andreika-git/deucalion/Connectors/pcb-connector-overview-2.png

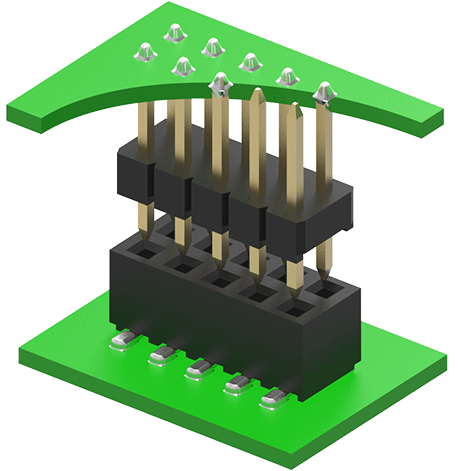
Connectors/pcb-connector-overview-2.png
