andreika-git/deucalion/sketches/3d_test1.jpg

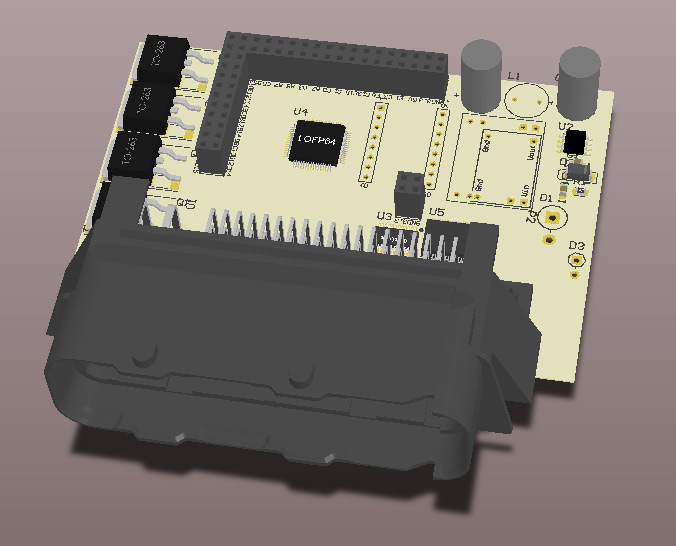
sketches/3d_test1.jpg
