andreika-git/deucalion/Core407v/README.md

# Core407V STM32F407VET6 Black board

Dimensions: 85.1mm x 72.45mm

More info at https://github.com/mcauser/BLACK_F407VE

Also, there's another board, with slightly different layout:
https://github.com/mcauser/BLACK_F407ZE
