andreika-git/deucalion/Core407z/README.md

# Core407z STM32F407ZET6 Black board

Dimensions: 95.1mm x 74.6mm

More info at https://github.com/mcauser/BLACK_F407ZE

Also, there's another board, with slightly different layout:
https://github.com/mcauser/BLACK_F407VE
