andreika-git/deucalion/Modules/STM32H743VIT6-mini/README.md

1st option:
	https://www.aliexpress.com/item/4000235276780.html
	= $19.73

2nd option:
	https://www.aliexpress.com/item/4000067780112.html
	= $30

3rd option:
	https://www.aliexpress.com/item/4000295397211.html
	= $23.80

4th option:
	https://www.aliexpress.com/item/4000063078887.html
	= $28.20
	* Size: 51mm x 47mm
	* no SD-card

5th option:
	NUCLEO-H743ZI or NUCLEO-H743ZI2
	https://www.digikey.com/product-detail/en/stmicroelectronics/NUCLEO-H743ZI2/497-19452-ND/10130892
	= $27.00
	https://www.aliexpress.com/item/32855593053.html
	= $34.10
