andreika-git/deucalion/Modules/STM32F407VET6-mini/README.md

# "STM32F407VET6 mini" "VCC-GND" Blue board

www.vcc-gnd.com
http://www.vcc-gnd.com/cp/stm32hxb/stm32f4xxhexinban/

Dimensions: 49.53mm x 39.37mm

More info at https://github.com/mcauser/VCC_GND_F407

https://wiki.stm32duino.com/index.php?title=Vcc-gnd.com_STM32F407VET6_Mini

https://www.ebay.com/itm/Mini-core-board-STM32-minimum-system-version-STM32F407VET6/182309828654
= $11.38
https://www.ebay.com/itm/Mini-core-board-STM32-minimum-system-version-STM32F407VET6/182169418538
= $11.89
https://www.ebay.com/itm/STM32F407VET6-ARM-Mini-Version-Core-Board-Cortex-M4-STM32-Minimum-System-Board/162558272520
= $15.35+delivery
https://www.ebay.com/itm/STM32F407VET6-Mini-version-of-the-core-board-STM32-minimum-system-version/182169418472
= $13
https://www.ebay.com/itm/STM32F407VET6-STM32-ARM-Cortex-M4-Development-Board-Core-Board-System-Board/123246623468
= $12
https://www.ebay.com/itm/STM32F407VET6-Mini-version-of-the-core-board-STM32-minimum-system-version/291791335845
= $13
https://www.ebay.com/itm/STM32F407VET6-Mini-version-of-the-Ader-Tafel-STM32-minimum-system-version/172387871994
= $14

https://www.aliexpress.com/item/Embedded-Development-Board-STM32F407VET6-Mini-Core-Board-Minimum-System-Version-STM32F4/32972483336.html
= $19
https://www.aliexpress.com/item/Source-STM32F407VET6-Version-Mini-Version-of-the-STM32-ARMCortex-M4-Core-Board-System/32819146937.html
= $24

There's a cheaper option WITHOUT SD-card slot (slightly bigger? :( ):
https://www.ebay.com/itm/STM32F407VGT6-ARM-Cortex-M4-32bit-MCU-Core-Development-Board-STM32F4Discovery/112159189243
= $9.38 (Black board)
https://www.ebay.com/itm/Open407V-D-Core407V-Development-Board-Standard-STM32F4-DISCOVERY-ARM-Cortex-M4/172740399220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
= $9.36 (Pink board, "STM32F407VGT6" option)

---------------------------------------

Upgrade options:
- replace CPU chip STM32F407VET6 with much more powerful STM32H743VI
- replace EEPROM chip AT24C08 with more capacious AT24CM02
- replace RT9193 regulator with more stable & high-current MIC5319-3.3YD5 (or with external 5V->3.3V regulator in SOT223 package)
