andreika-git/deucalion/Modules/LIN/README.md

*** LIN/K-line ISO9141 Transceiver Module ***

Header connector pinout:
1 = +V12
2 = +3.3V
3 = GND
4 = RX
5 = TX
6 = LIN

IC used: TJA1029

Module board dims: 16x12 mm 
(2 layer board)
