andreika-git/deucalion/Connectors/Siemens_SIMK41/README.md

Siemens 5WY SIMK41/43 (2 connectors) pinout (partial, not confirmed):
	http://carmasters.org/topic/2373-%D1%8D%D0%B1%D1%83-siemens/?page=2
2: ground
3: +12 permanent (K30)
6: CAN-L
7: CAN-H
22: +12 ignition (K15)
47: K-Line (programming)
77: K-Line (diagnostics)
