andreika-git/deucalion/Core407_pinout_compare.xlsx

Sheet: Лист1
 | Port A |  |  |  |  | Port B |  |  |  |  | Port C |  |  |  |  | Port D |  |  |  |  | Port E |  |  |  | Port F |  |  |  | Port G
PIN | function | board | VE | ZE | Min | function | board | VE | ZE | Min | function | board | VE | ZE | Min | function | board | VE | ZE | Min | function | VE | ZE | Min | function | VE | ZE | Min | function | VE | ZE | Min
0 | UTX4 | BTN | 23 | 23 | 21 |  | FLASH | 33 | 33 | 31 |  |  | 17 | 19 | 17 | CRX1 |  | 126 | 122 | 216 |  | 112 | 2 | 7 |  |  | 10 |  |  |  | 41
1 | URX4 |  | 24 | 26 | 23 |  |  | 34 | 36 | 32 |  |  | 18 | 22 | 18 | CTX1 |  | 125 | 121 | 127 |  | 111 | 1 | 8 |  |  | 9 |  |  |  | 44
2 | UTX2 |  | 25 | 25 | 22 | BOOT1 | BOOT1 |  | 35 | 33 | MISO2 |  | 19 | 21 | 19 | URX5 | MMC | 124 | 120 | 218 |  | 11 | 4 | 9 |  |  | 12 |  |  |  | 144
3 | URX2 |  | 26 | 28 | 24 | SCK13* | FLASH | 118 | 107 | 224 | MOSI2 |  | 20 | 24 | 20 |  |  | 123 | 119 | 219 |  | 12 | 3 | 10 |  |  | 11 |  |  |  | 143
4 |  |  | 27 | 27 | 25 | MISO13 | FLASH |  | 106 | 225 |  |  | 31 | 31 | 29 |  |  | 122 | 118 | 220 |  | 13 | 6 | 11 |  |  | 14 |  |  |  | 142
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
