andreika-git/deucalion/Connectors/55_BS032.jpg

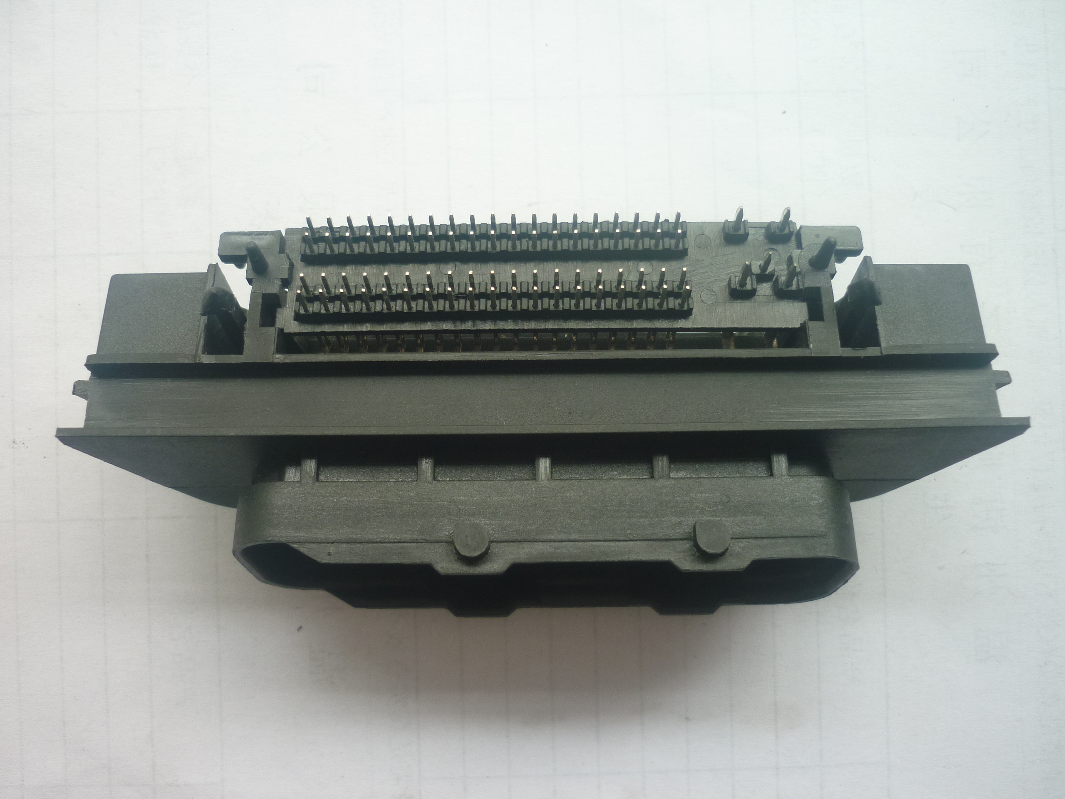
Connectors/55_BS032.jpg
