andreika-git/deucalion/Connectors/55_BS032_2.jpg

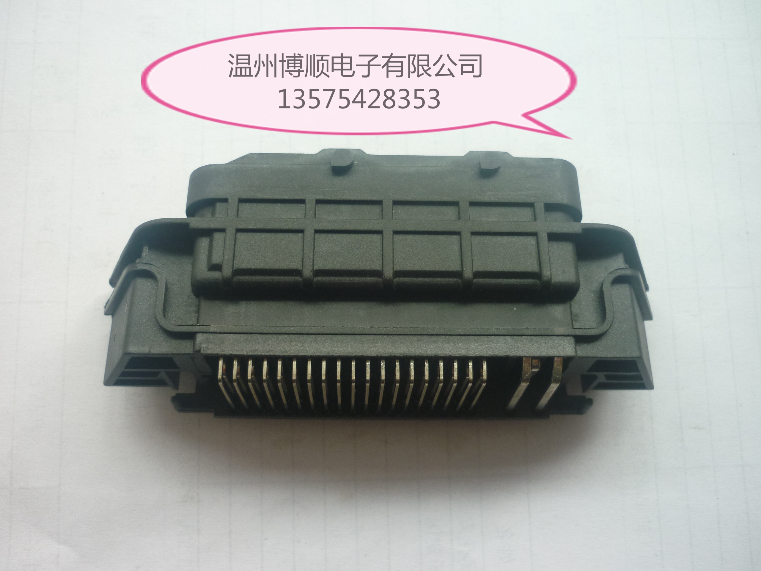
Connectors/55_BS032_2.jpg
