andreika-git/deucalion/Connectors/DJ7811-1-3.5-10-photo02.jpg

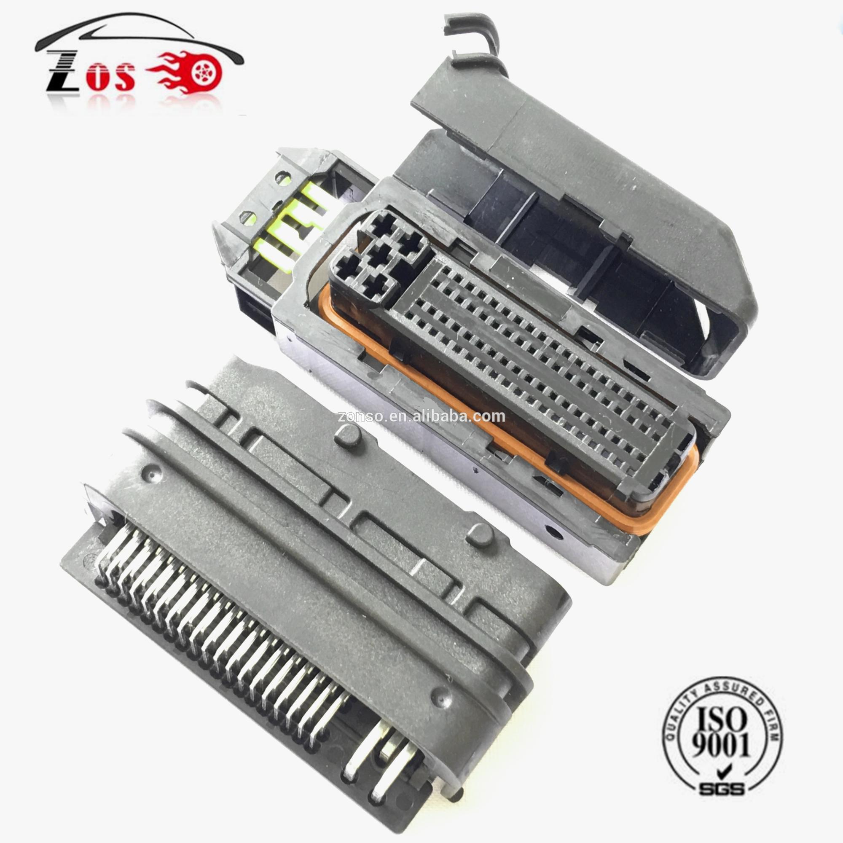
Connectors/DJ7811-1-3.5-10-photo02.jpg
