andreika-git/deucalion/Connectors/DJ7811-1.2-3.5-11.jpg

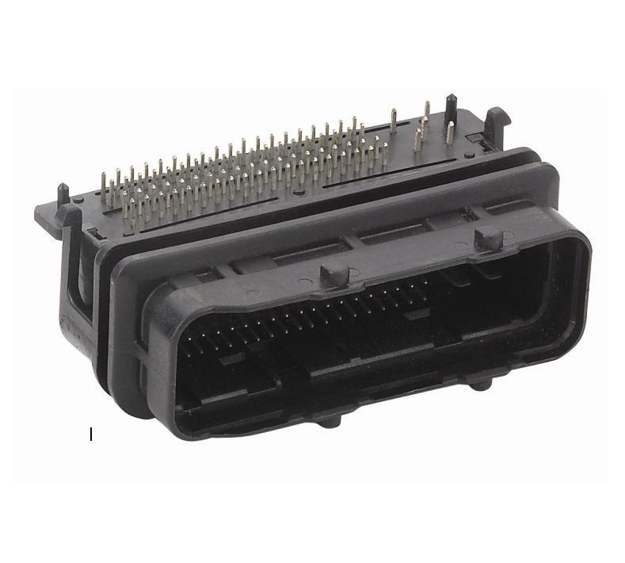
Connectors/DJ7811-1.2-3.5-11.jpg
