andreika-git/deucalion/Connectors/M7.9.7/7.9.7-1.jpg

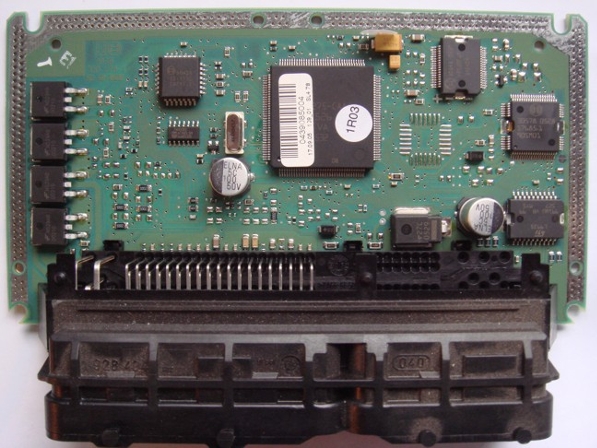
Connectors/M7.9.7/7.9.7-1.jpg
