andreika-git/deucalion/Connectors/M7.9.7/7.9.7-124-1.jpg

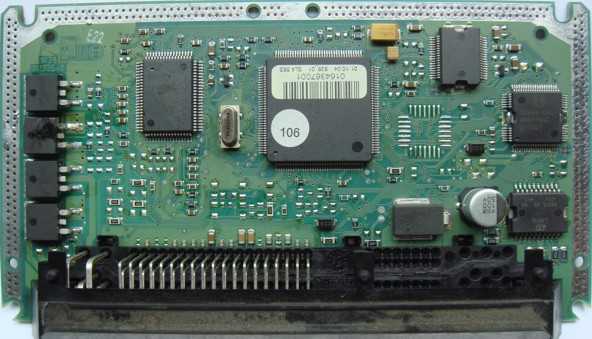
Connectors/M7.9.7/7.9.7-124-1.jpg
