andreika-git/deucalion/Connectors/M7.9.7/121pin_housing_with_connector_inside.jpg

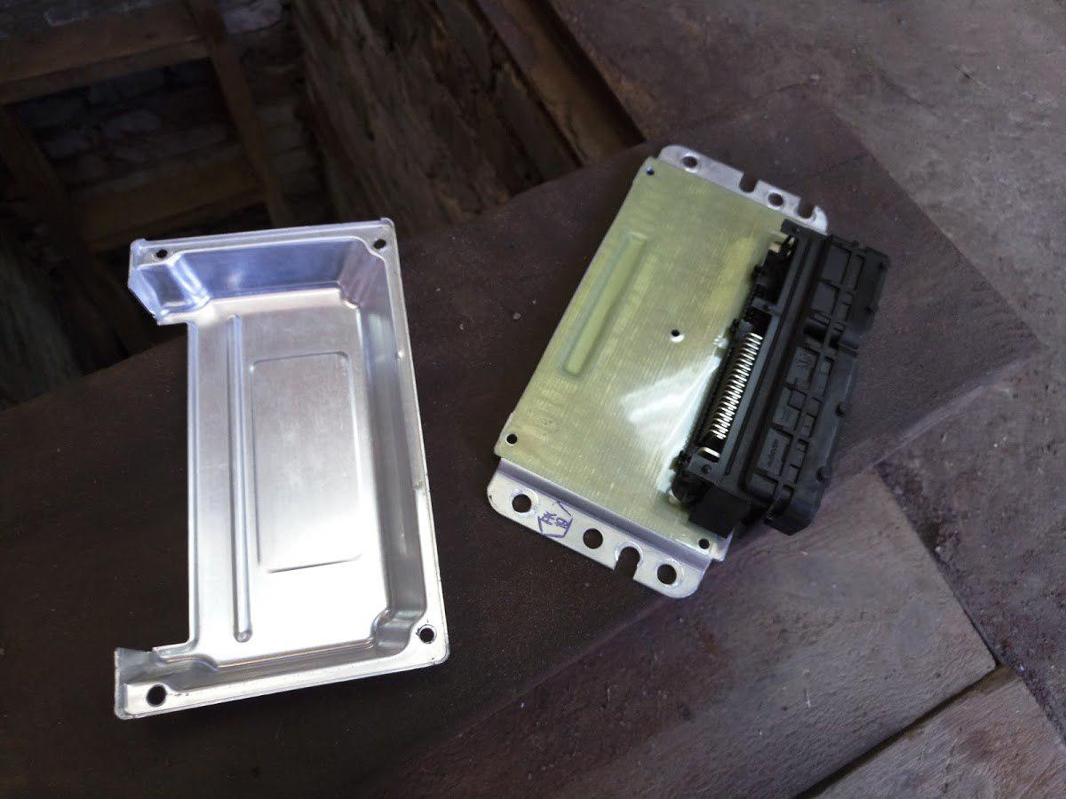
Connectors/M7.9.7/121pin_housing_with_connector_inside.jpg
