andreika-git/deucalion/Connectors/M7.9.7/1118-22-1.jpg

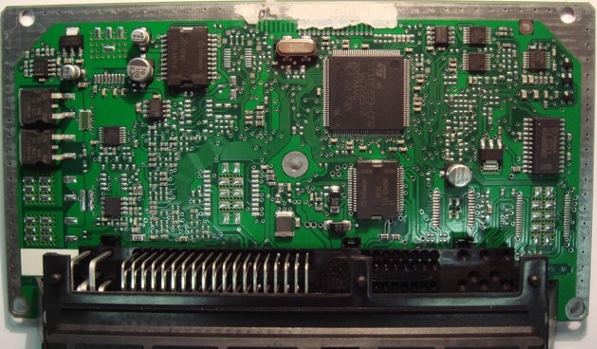
Connectors/M7.9.7/1118-22-1.jpg
