andreika-git/deucalion/Connectors/M7.9.7/2111-82-1.jpg

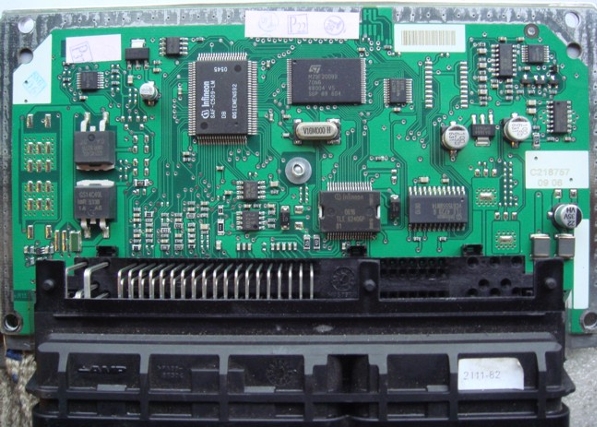
Connectors/M7.9.7/2111-82-1.jpg
