andreika-git/deucalion/Connectors/M7.9.7/11183-22-1.jpg

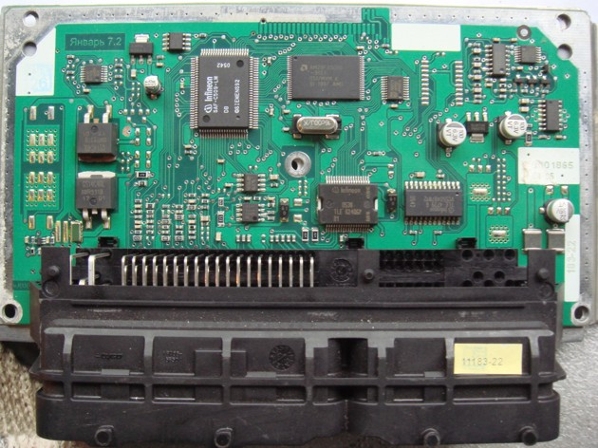
Connectors/M7.9.7/11183-22-1.jpg
