andreika-git/deucalion/Connectors/M7.9.7/21067-12-1.jpg

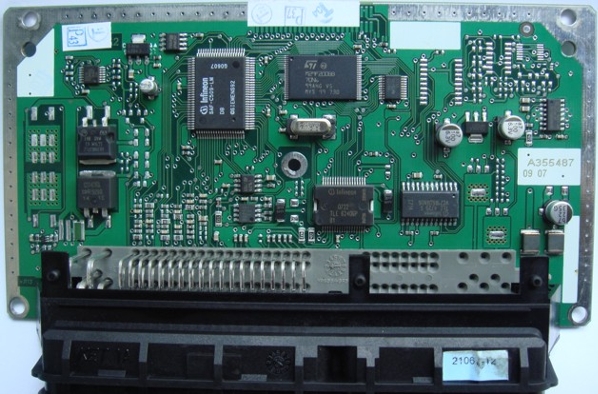
Connectors/M7.9.7/21067-12-1.jpg
