andreika-git/deucalion/Connectors/M7.9.7/21126-1-1.jpg

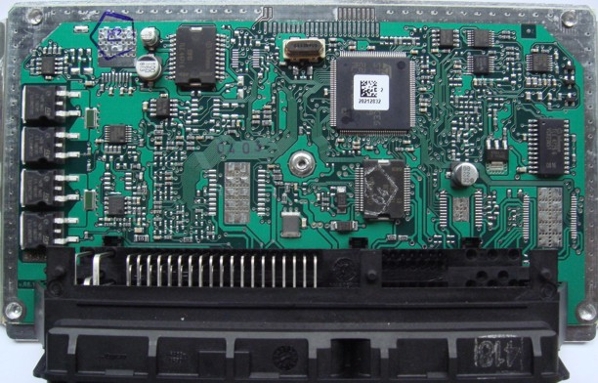
Connectors/M7.9.7/21126-1-1.jpg
