andreika-git/deucalion/Connectors/M7.9.7/board02.jpg

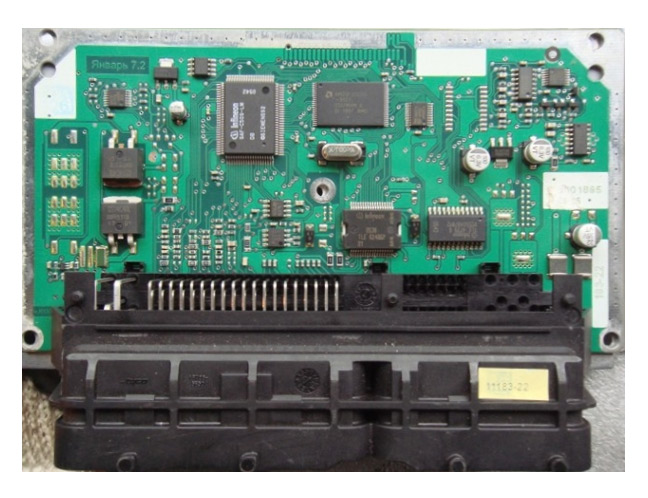
Connectors/M7.9.7/board02.jpg
