andreika-git/deucalion/Connectors/M7.9.7/Bosch_M7.9.7_pinout (janvar72_2111-1411020-8x).gif

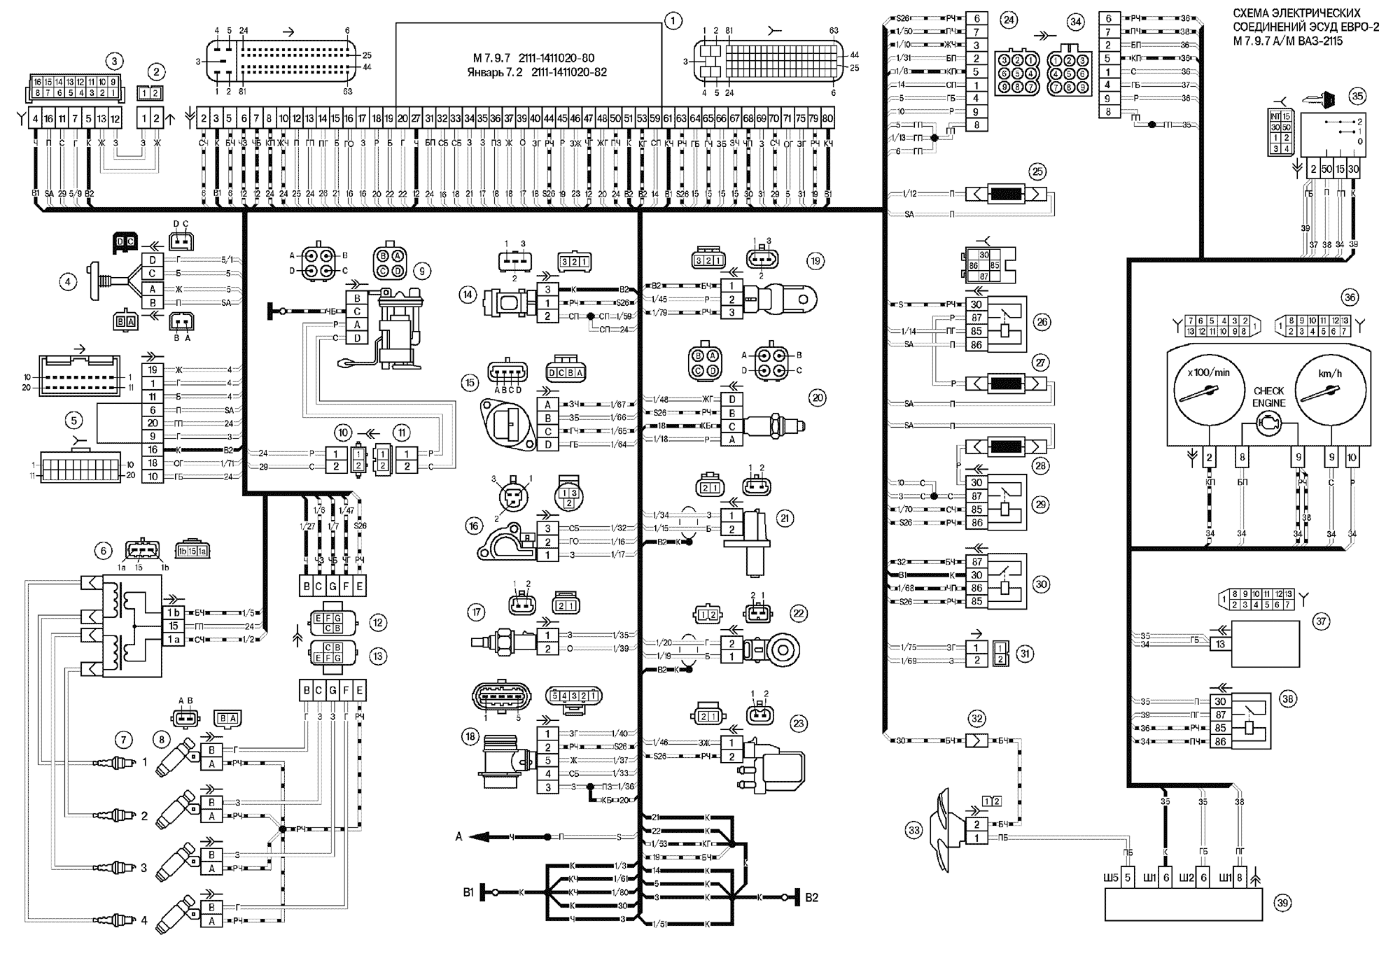
Connectors/M7.9.7/Bosch_M7.9.7_pinout (janvar72_2111-1411020-8x).gif
