andreika-git/deucalion/Connectors/M7.9.7/Bosch_M7.9.7_pinout_rus.jpg

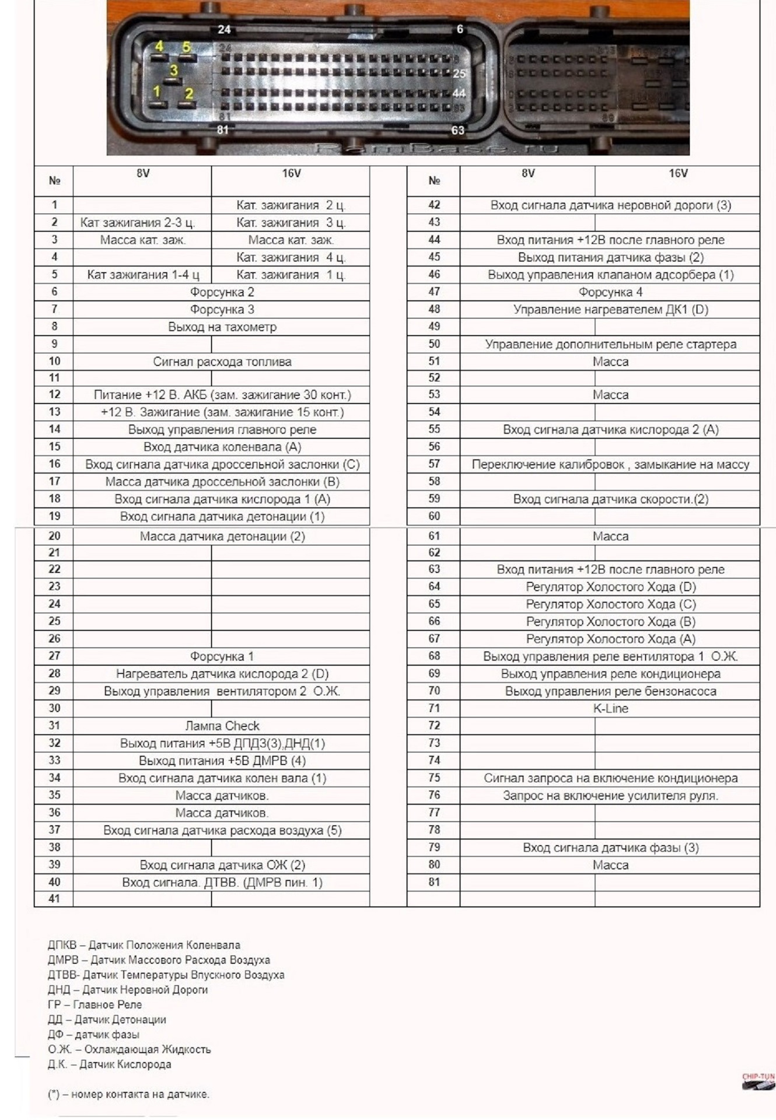
Connectors/M7.9.7/Bosch_M7.9.7_pinout_rus.jpg
