andreika-git/deucalion/Connectors/M7.9.7/chinese_121p.jpg

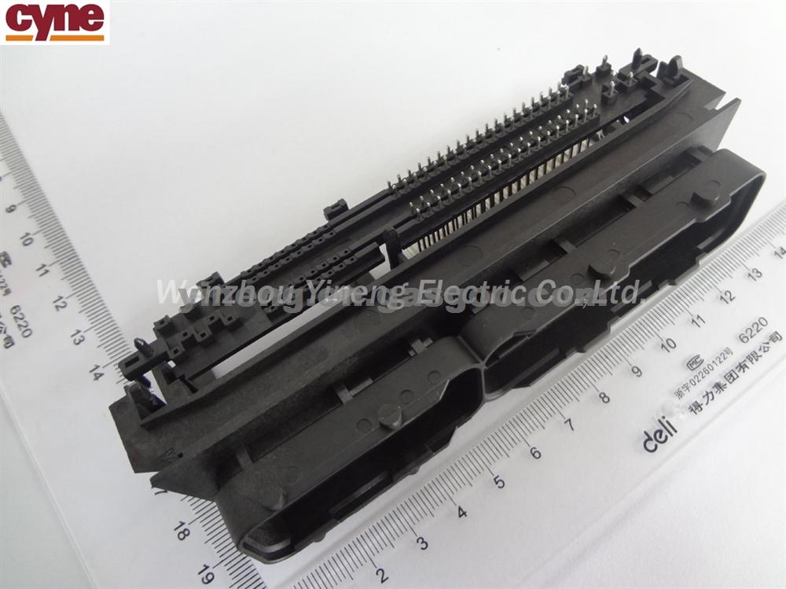
Connectors/M7.9.7/chinese_121p.jpg
