andreika-git/deucalion/Connectors/M7.9.7/janvar72_21124-1411020.jpg

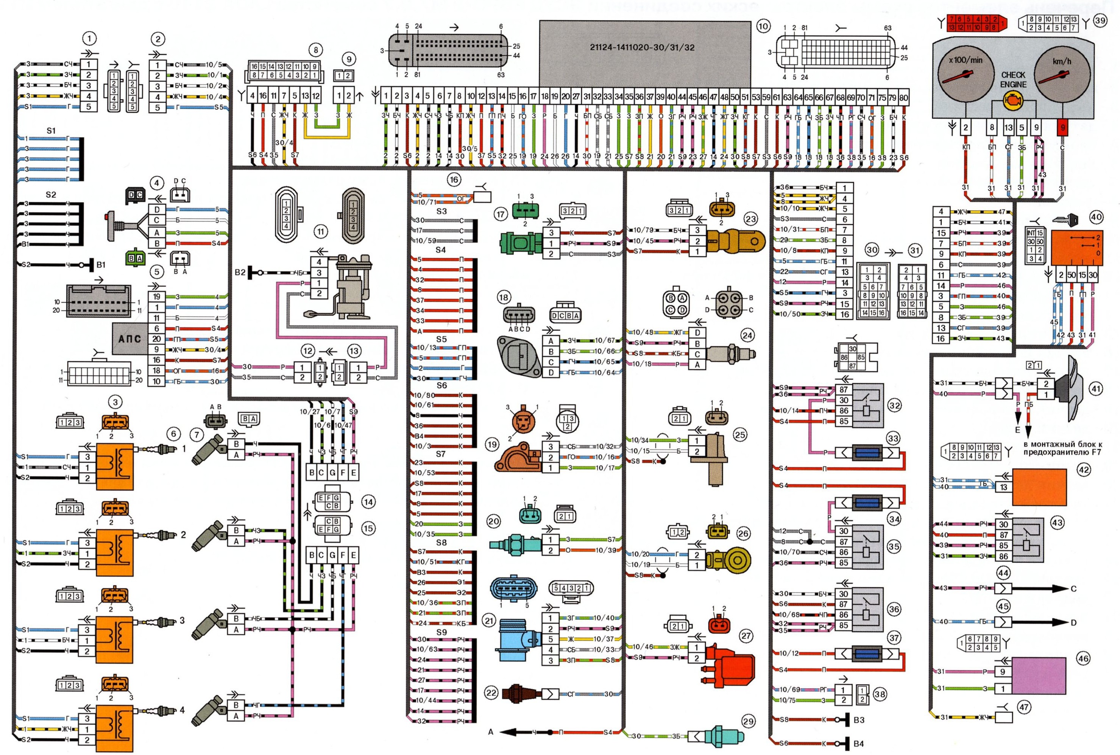
Connectors/M7.9.7/janvar72_21124-1411020.jpg
