andreika-git/deucalion/Connectors/M7.9.7/power-ignition-transistors-footprint-reference.jpg

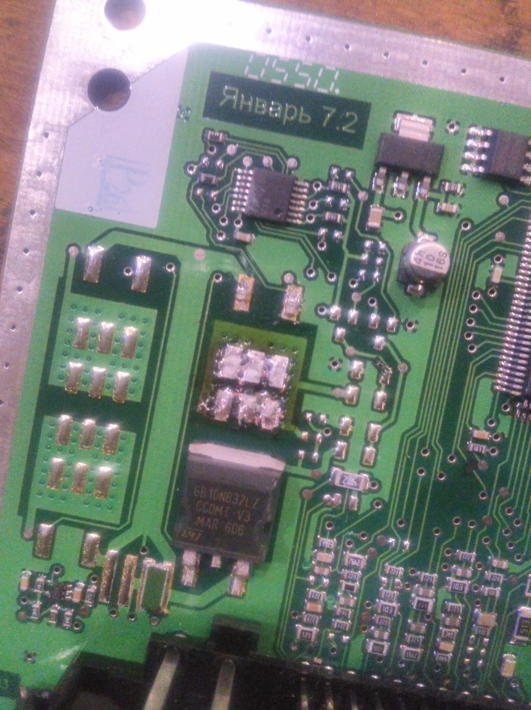
Connectors/M7.9.7/power-ignition-transistors-footprint-reference.jpg
