andreika-git/deucalion/Connectors/ME7.8.8/photo03.jpg

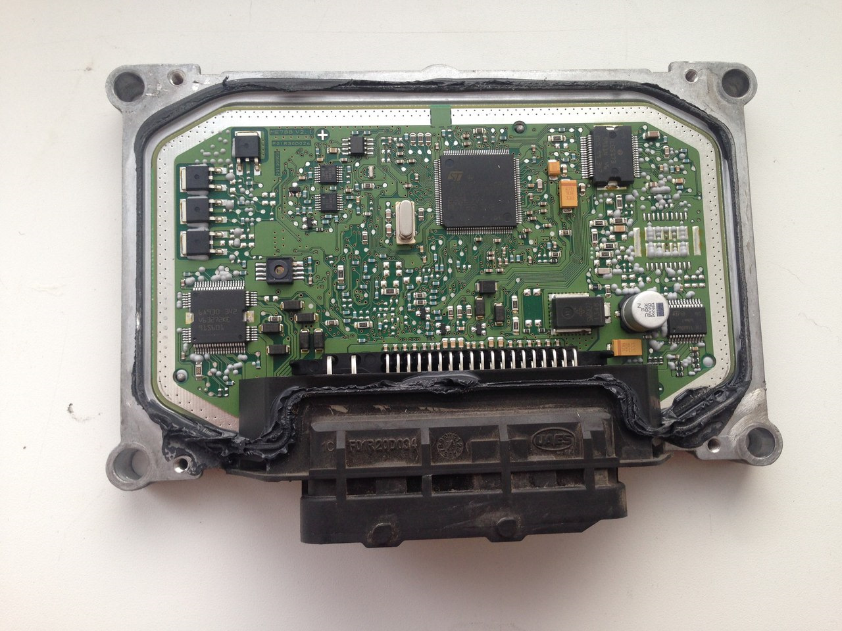
Connectors/ME7.8.8/photo03.jpg
