andreika-git/deucalion/Connectors/Mikas10.3/COATE-31.3763 000-10-photo02.jpg

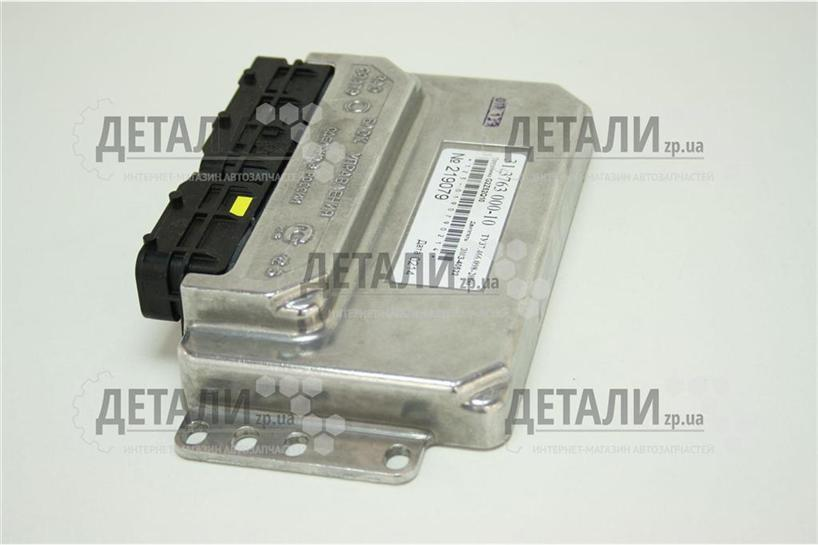
Connectors/Mikas10.3/COATE-31.3763 000-10-photo02.jpg
