andreika-git/deucalion/Connectors/Mikas10.3/Mikas_M10.3_chips.jpg

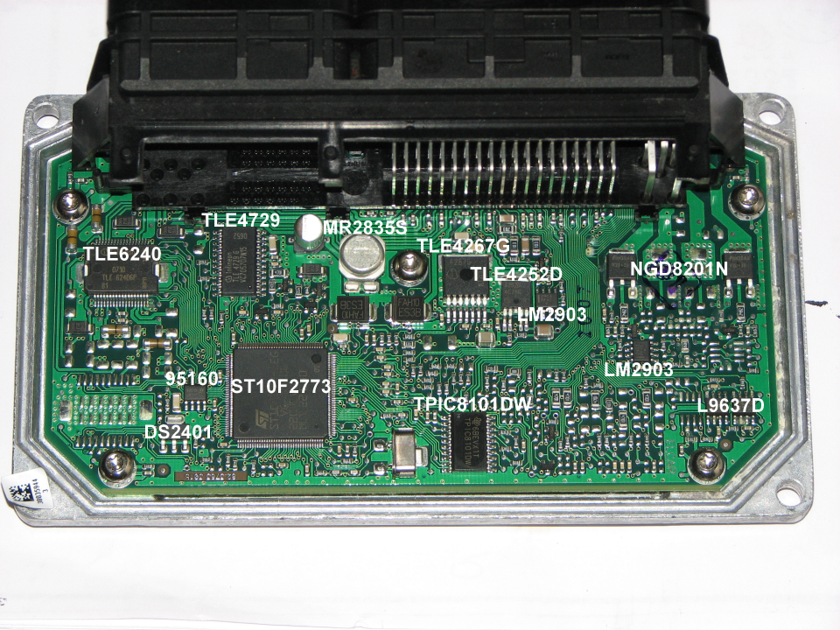
Connectors/Mikas10.3/Mikas_M10.3_chips.jpg
