andreika-git/deucalion/Connectors/Mikas10.3/Mikas_M113_label.jpg

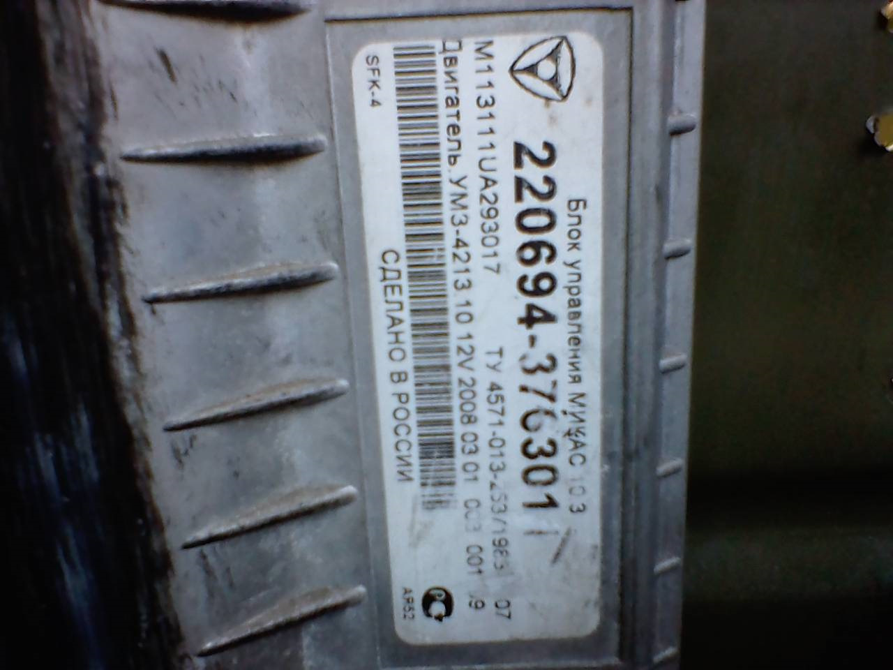
Connectors/Mikas10.3/Mikas_M113_label.jpg
