andreika-git/deucalion/Connectors/Mikas10.3/Mikas_M114_photo01.jpg

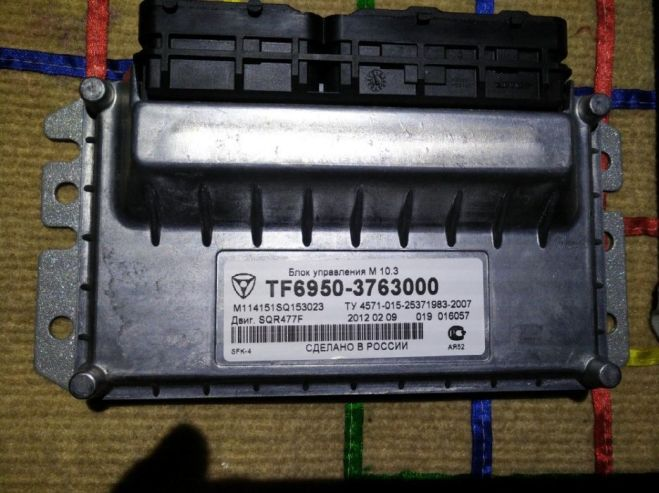
Connectors/Mikas10.3/Mikas_M114_photo01.jpg
