andreika-git/deucalion/Connectors/Mikas10.3/Mikas_M114_photo03.jpg

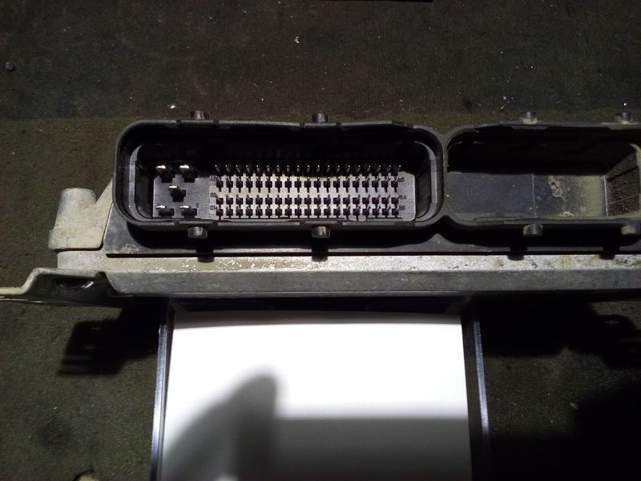
Connectors/Mikas10.3/Mikas_M114_photo03.jpg
