andreika-git/deucalion/Connectors/Mikas10.3/Mikas_M114_photo04.jpg

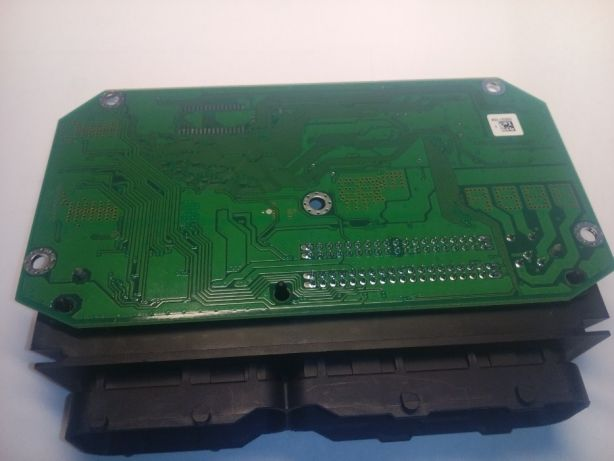
Connectors/Mikas10.3/Mikas_M114_photo04.jpg
