andreika-git/deucalion/Connectors/pcb-connector-overview-1.png

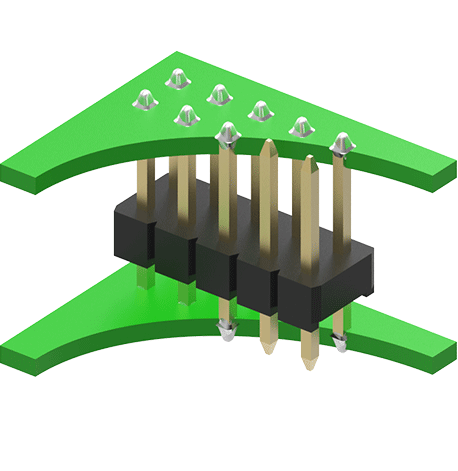
Connectors/pcb-connector-overview-1.png
