andreika-git/deucalion/Connectors/PL811-11/81-Pin-Tyco-Amp-TE-connectivity-ECU-05.jpg

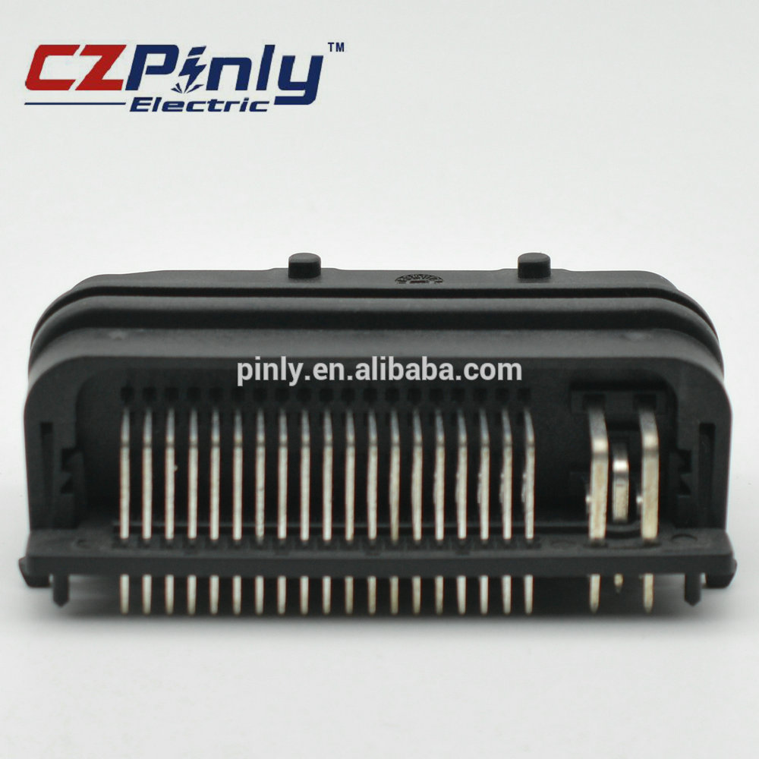
Connectors/PL811-11/81-Pin-Tyco-Amp-TE-connectivity-ECU-05.jpg
