andreika-git/deucalion/Connectors/Siemens_SIMK41/photo01.jpg

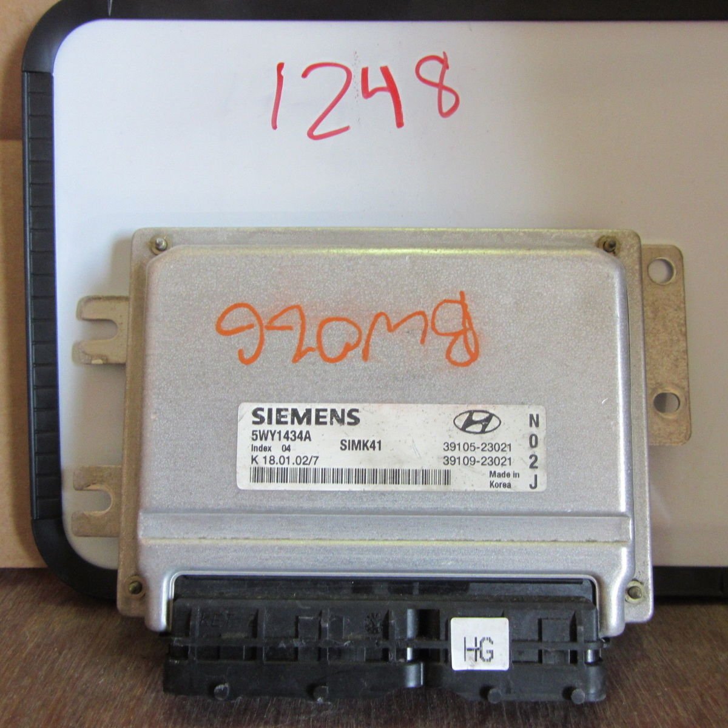
Connectors/Siemens_SIMK41/photo01.jpg
