andreika-git/deucalion/Connectors/Siemens_SIMK41/photo02.jpg

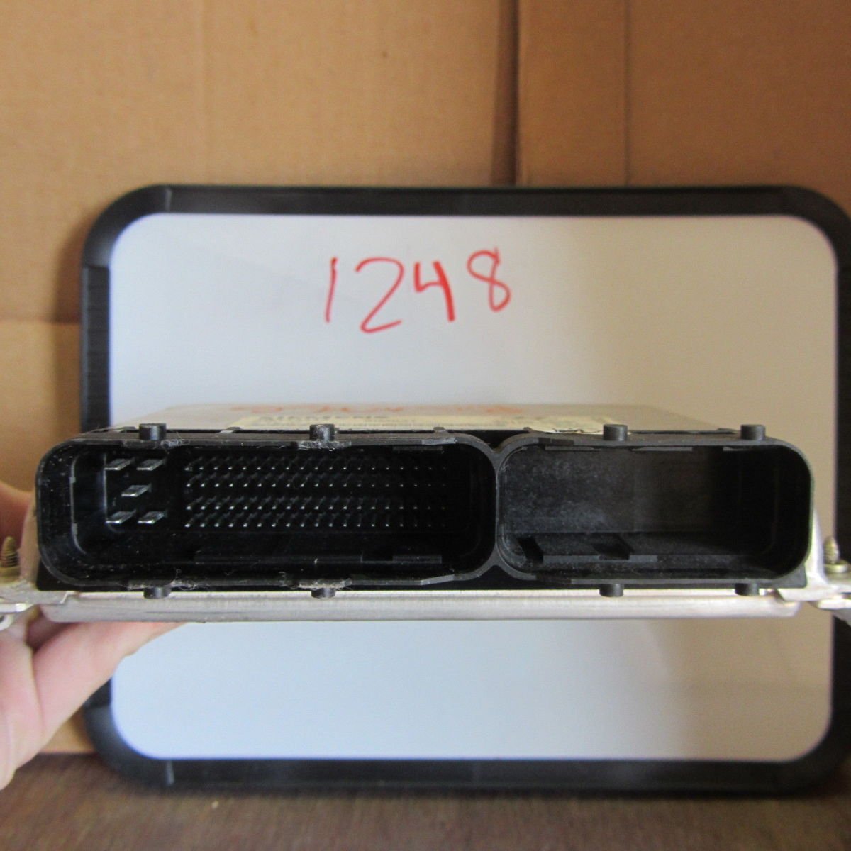
Connectors/Siemens_SIMK41/photo02.jpg
