andreika-git/deucalion/Connectors/Siemens_SIMK41/photo03.jpg

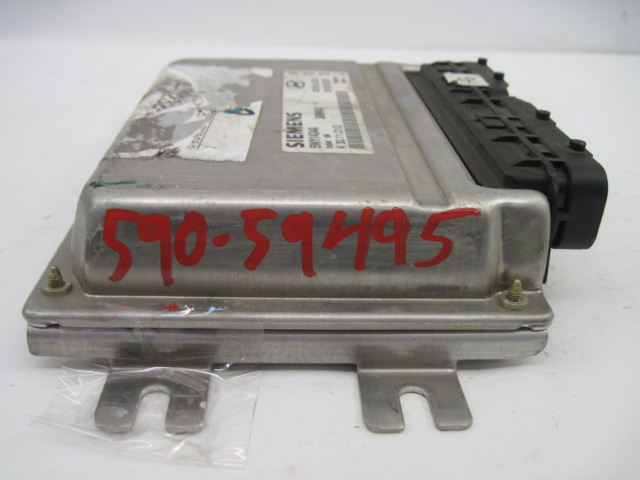
Connectors/Siemens_SIMK41/photo03.jpg
