andreika-git/deucalion/Core407_pinout_compare.png

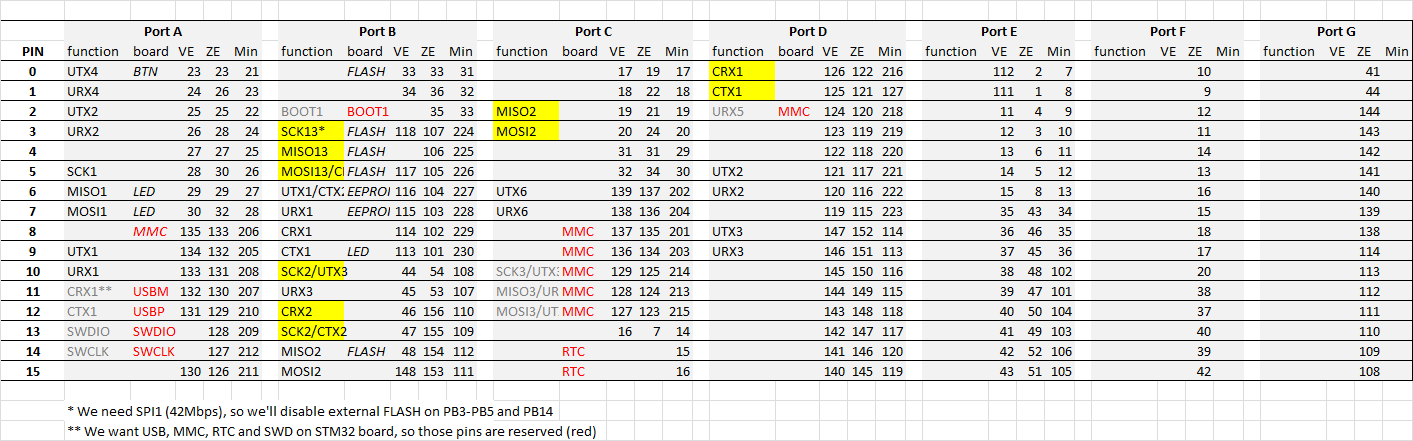
Core407_pinout_compare.png
