andreika-git/deucalion/Core407v/board01.jpg

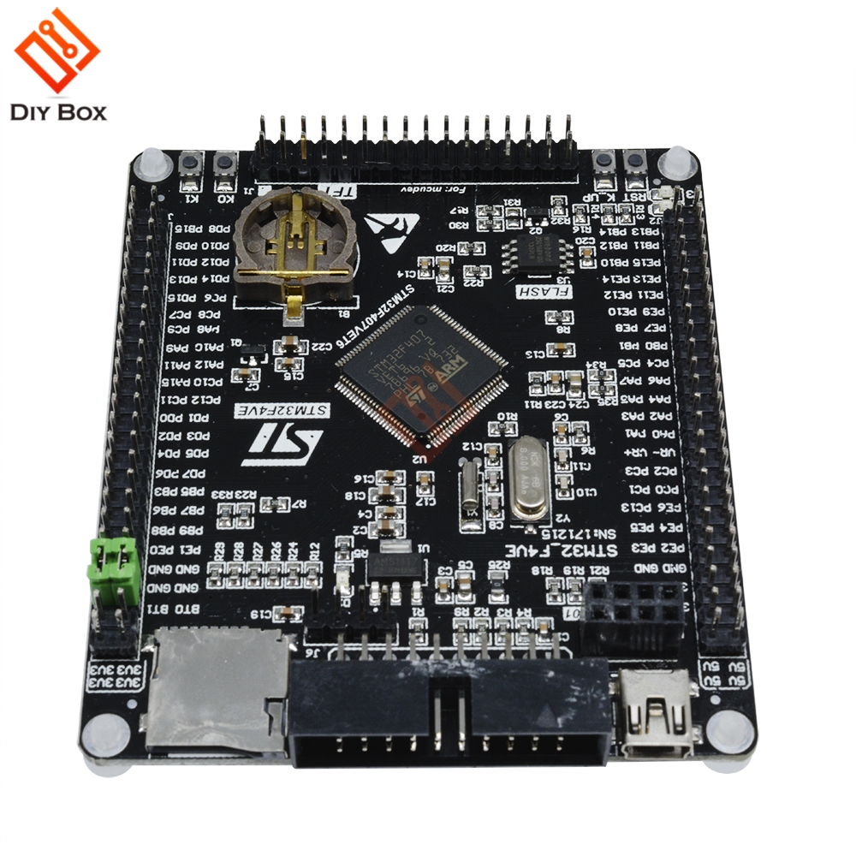
Core407v/board01.jpg
