andreika-git/deucalion/Core407v/board02.jpg

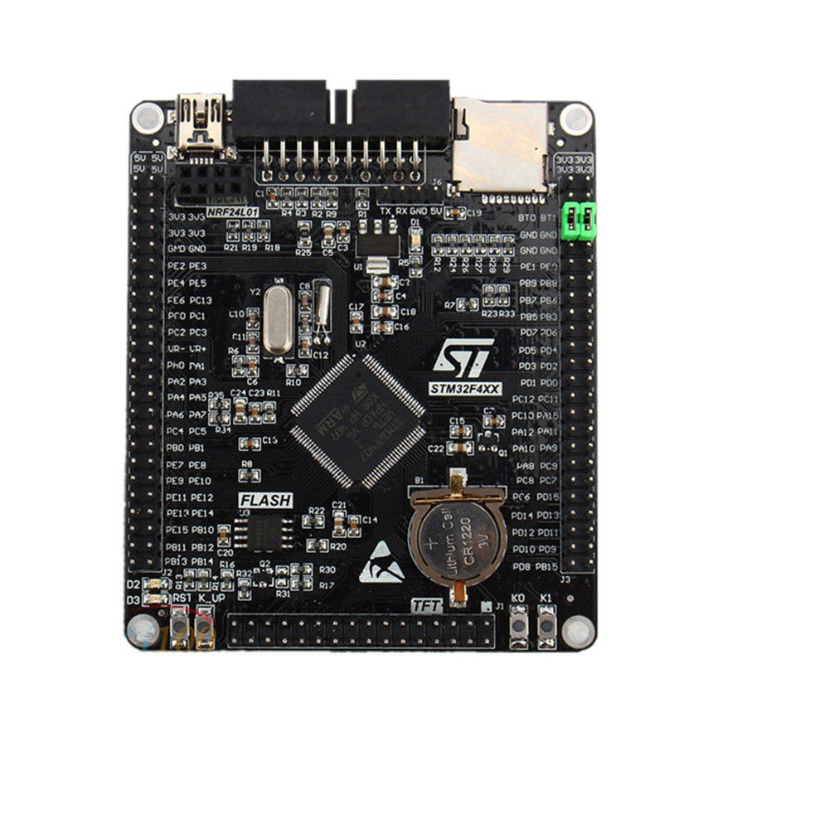
Core407v/board02.jpg
