andreika-git/deucalion/Core407v/board03.jpg

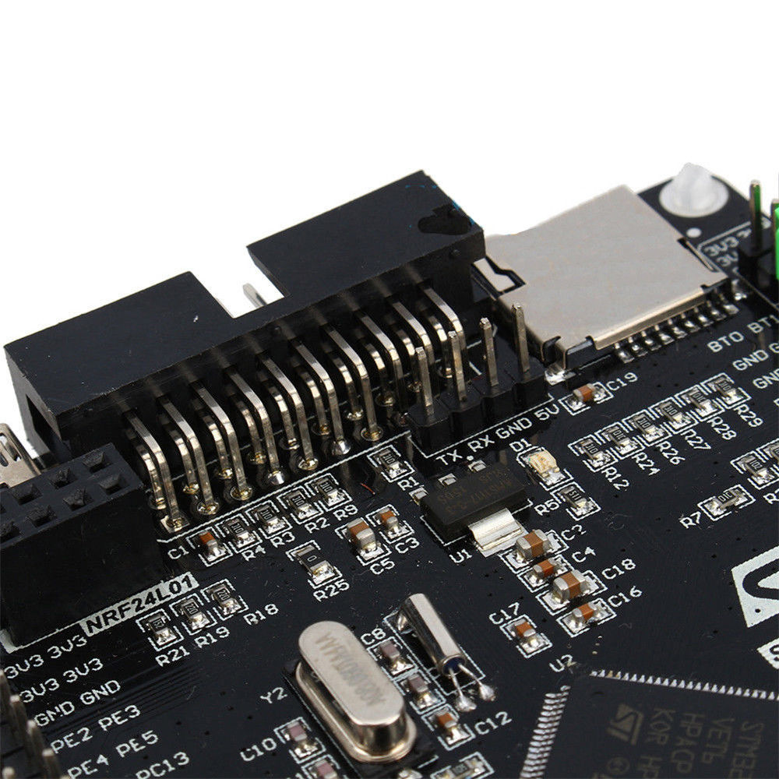
Core407v/board03.jpg
