andreika-git/deucalion/Core407v/board04.jpg

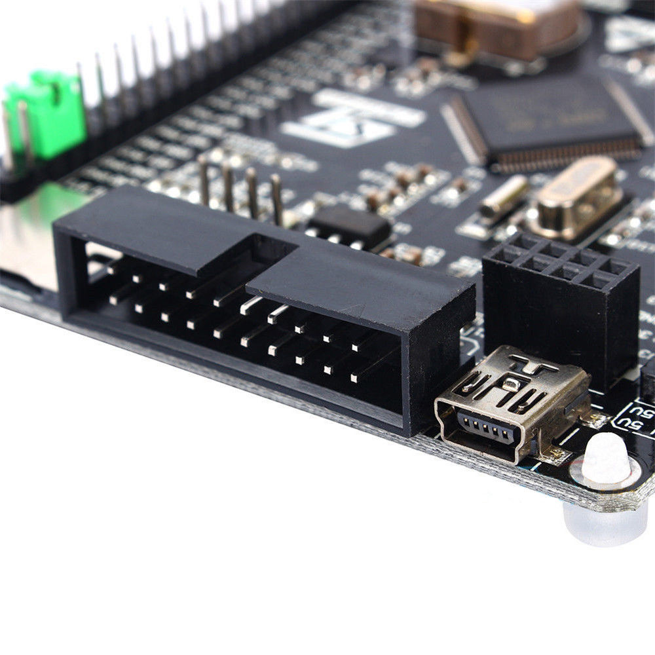
Core407v/board04.jpg
