andreika-git/deucalion/Core407v/board05.jpg

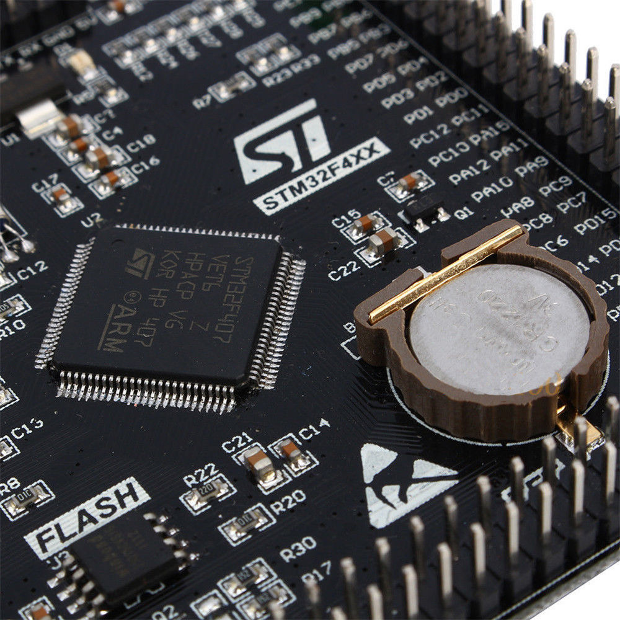
Core407v/board05.jpg
