andreika-git/deucalion/Core407v/board06.jpg

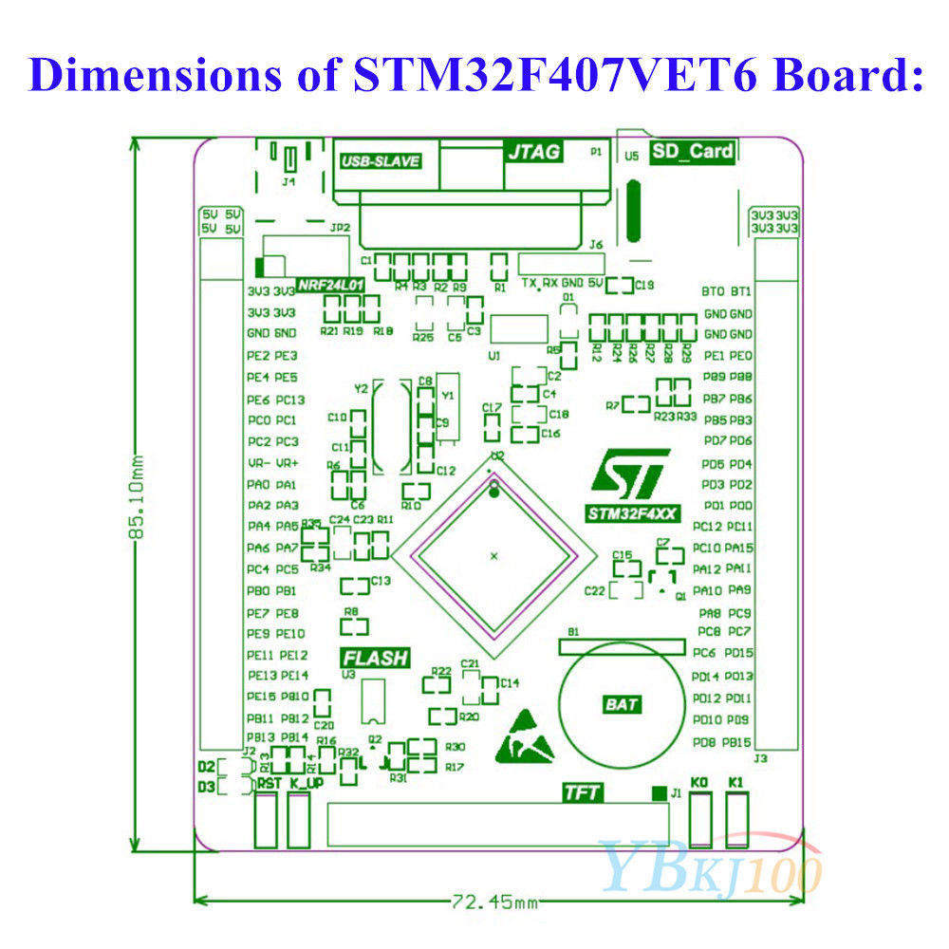
Core407v/board06.jpg
