andreika-git/deucalion/Core407v/board_407_dims_estimate.jpg

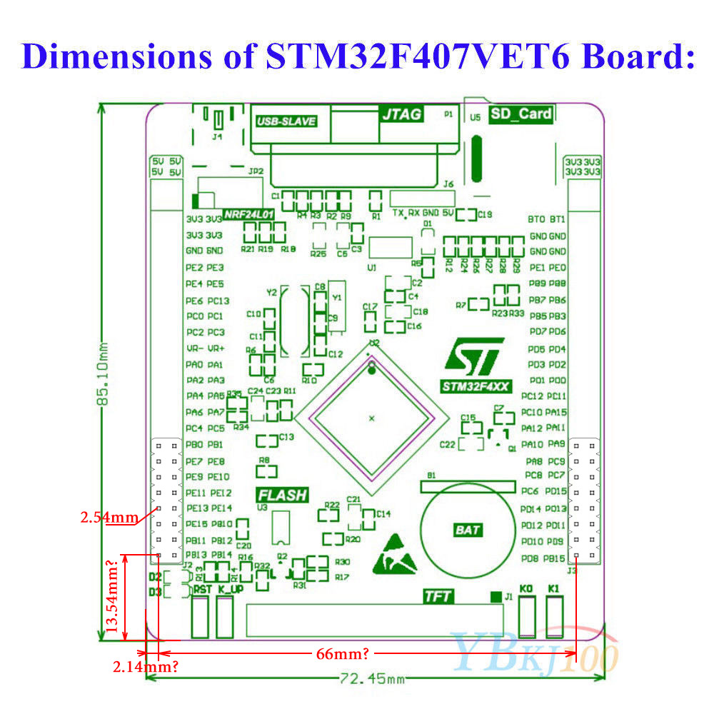
Core407v/board_407_dims_estimate.jpg
