andreika-git/deucalion/Core407z/board02.jpg

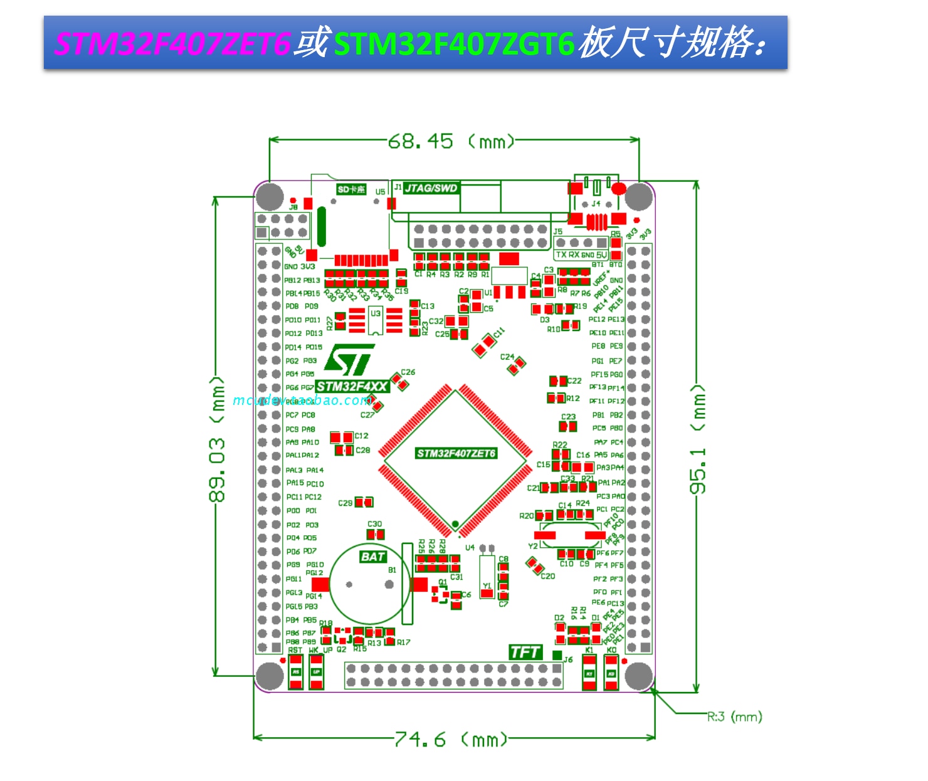
Core407z/board02.jpg
