andreika-git/deucalion/Modules/CAN-CJMCU-230-SN65HVD230-photo01.jpg

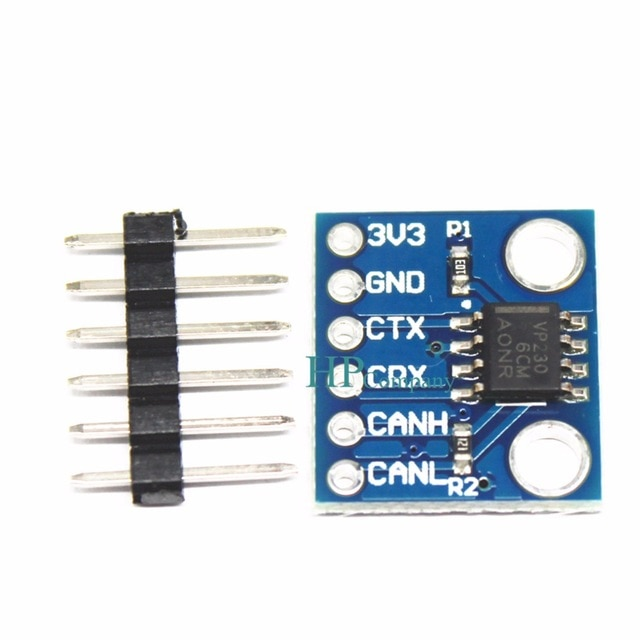
Modules/CAN-CJMCU-230-SN65HVD230-photo01.jpg
