andreika-git/deucalion/Modules/CAN-CJMCU-230-SN65HVD230-photo02.jpg

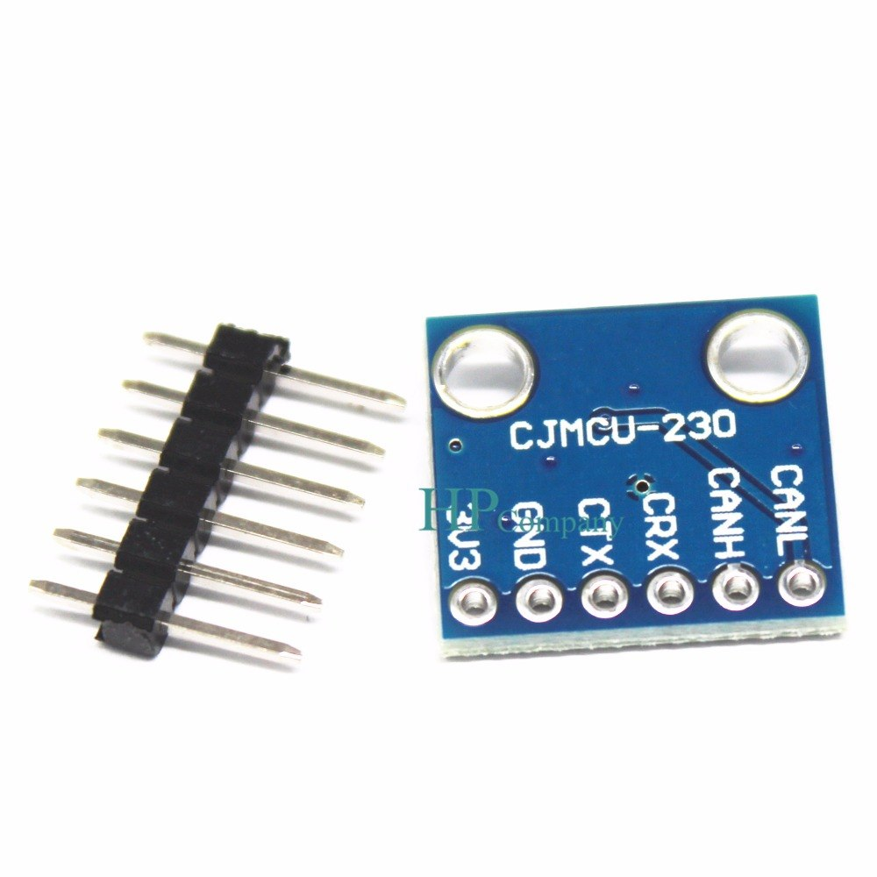
Modules/CAN-CJMCU-230-SN65HVD230-photo02.jpg
