andreika-git/deucalion/Modules/CAN-CJMCU-1051-TJA1051-photo02.jpg

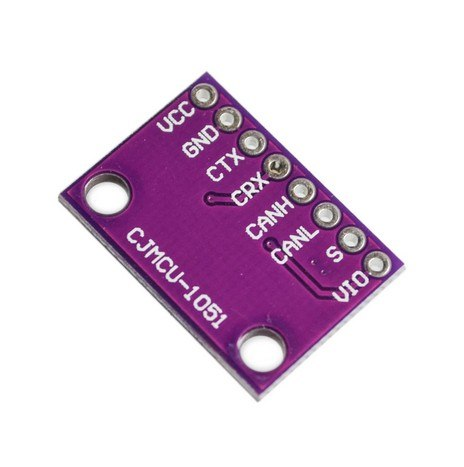
Modules/CAN-CJMCU-1051-TJA1051-photo02.jpg
