andreika-git/deucalion/Modules/CAN-MCP2551-photo01.jpg

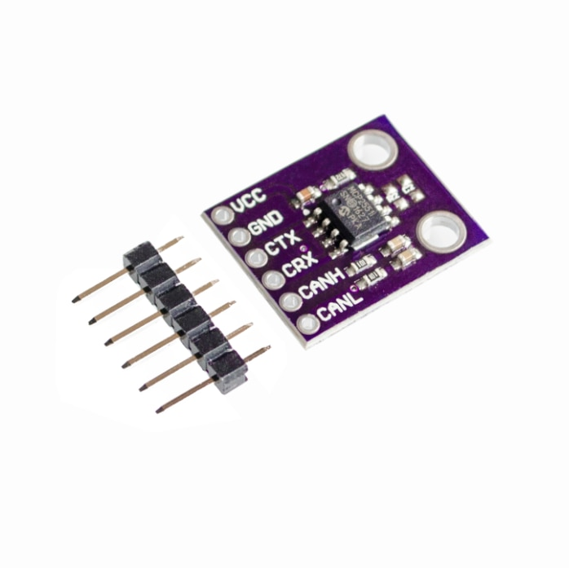
Modules/CAN-MCP2551-photo01.jpg
