andreika-git/deucalion/Modules/CAN-MCP2551-photo02.jpg

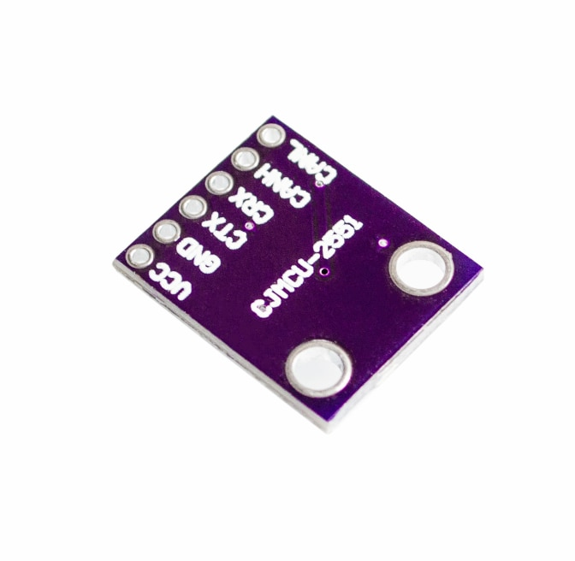
Modules/CAN-MCP2551-photo02.jpg
