andreika-git/deucalion/Modules/DC-DC-16-10-footprint.jpg

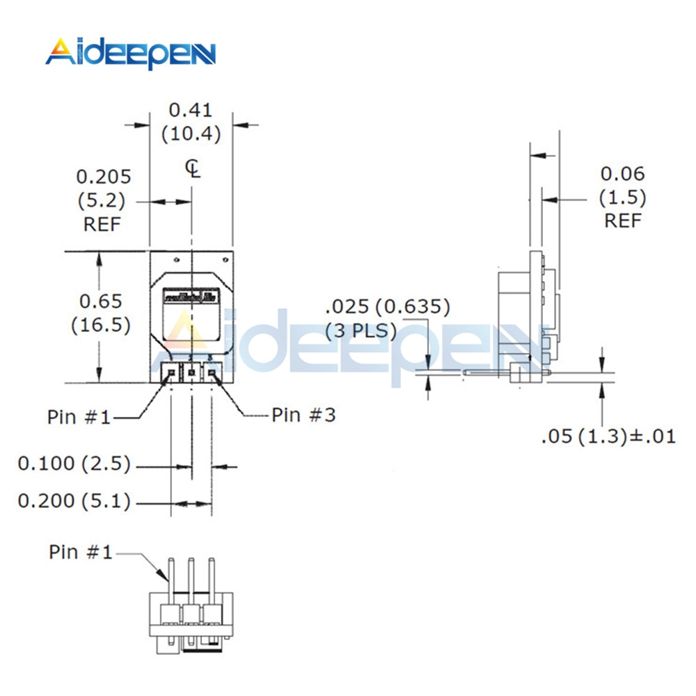
Modules/DC-DC-16-10-footprint.jpg
