andreika-git/deucalion/Modules/DC-DC-16-10-Green-photo01.jpg

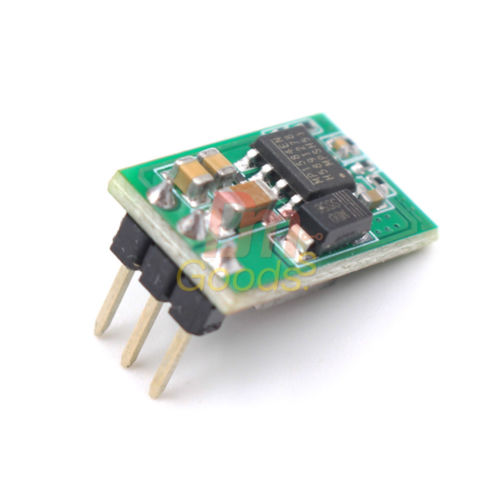
Modules/DC-DC-16-10-Green-photo01.jpg
