andreika-git/deucalion/Modules/DC-DC-17-12-Black-photo01.jpg

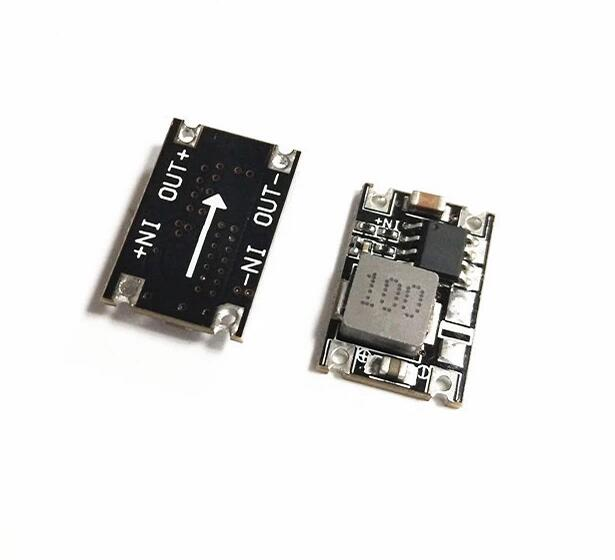
Modules/DC-DC-17-12-Black-photo01.jpg
