andreika-git/deucalion/Modules/DC-DC-17-12-footprint2.jpg

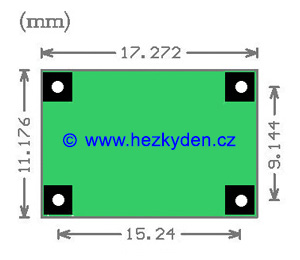
Modules/DC-DC-17-12-footprint2.jpg
