andreika-git/deucalion/Modules/DC-DC-17-12-footprint.jpg

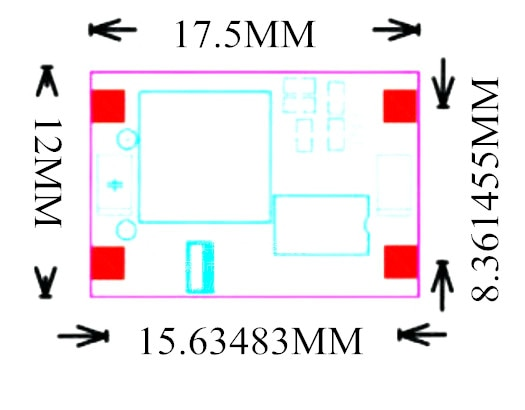
Modules/DC-DC-17-12-footprint.jpg
