andreika-git/deucalion/Modules/DC-DC-17-12-Green-ADJ-Mini360-photo01.png

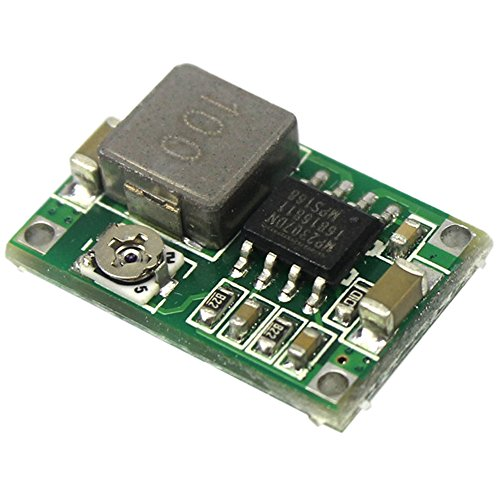
Modules/DC-DC-17-12-Green-ADJ-Mini360-photo01.png
