andreika-git/deucalion/Modules/DC-DC-20-11-Green-photo02.jpg

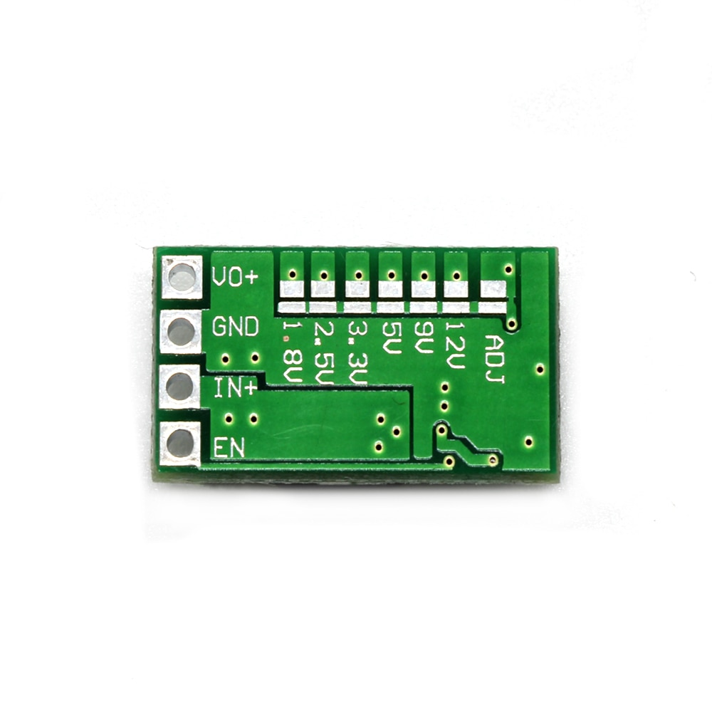
Modules/DC-DC-20-11-Green-photo02.jpg
