andreika-git/deucalion/Modules/DC-DC-22-17-Black-photo01.jpg

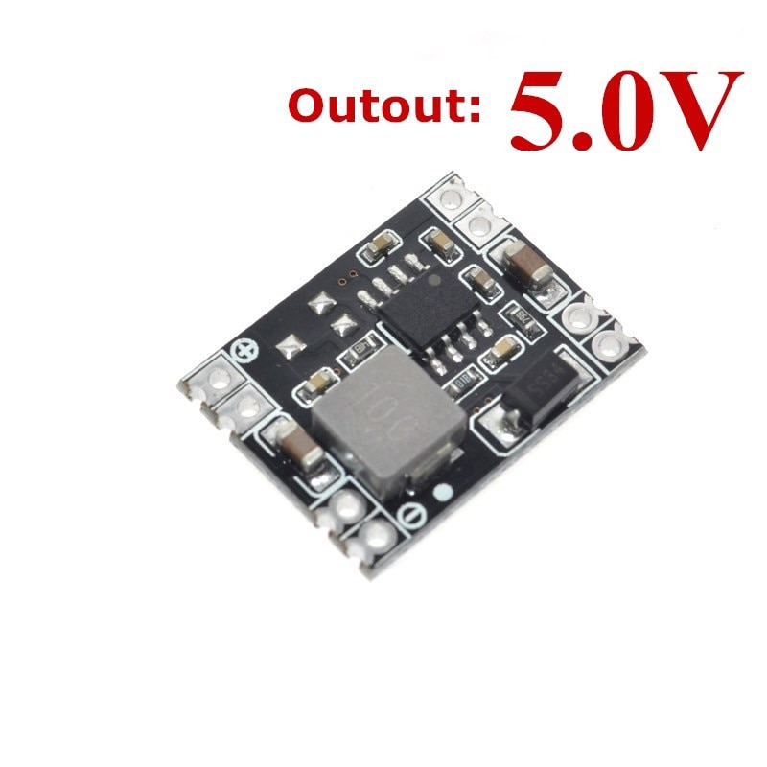
Modules/DC-DC-22-17-Black-photo01.jpg
