andreika-git/deucalion/Modules/DC-DC-22-17-footprint.jpg

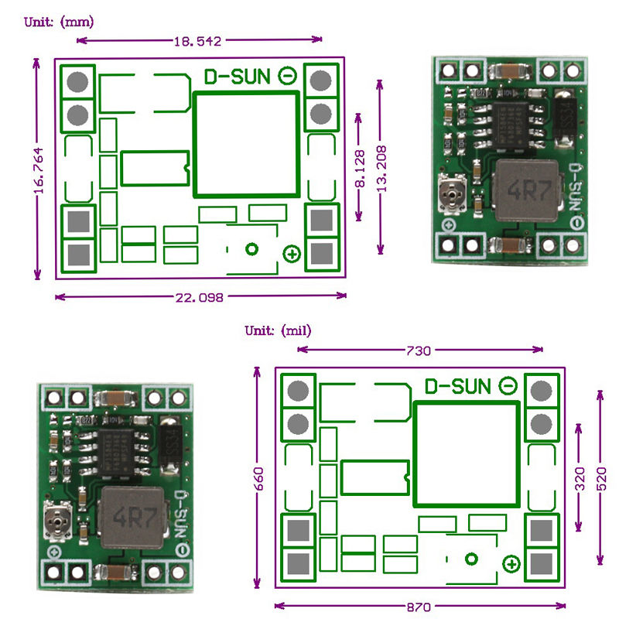
Modules/DC-DC-22-17-footprint.jpg
