andreika-git/deucalion/Modules/DC-DC-22-17-Green-photo01.jpg

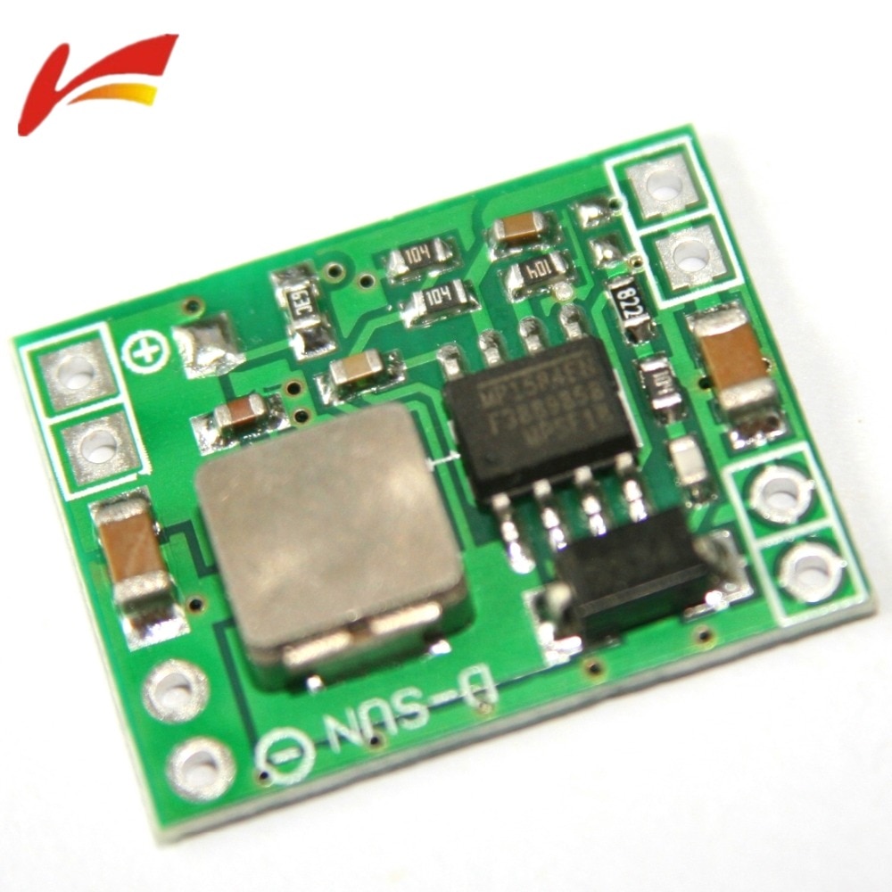
Modules/DC-DC-22-17-Green-photo01.jpg
