andreika-git/deucalion/Modules/DC-DC-22-17-Red-footprint.jpg

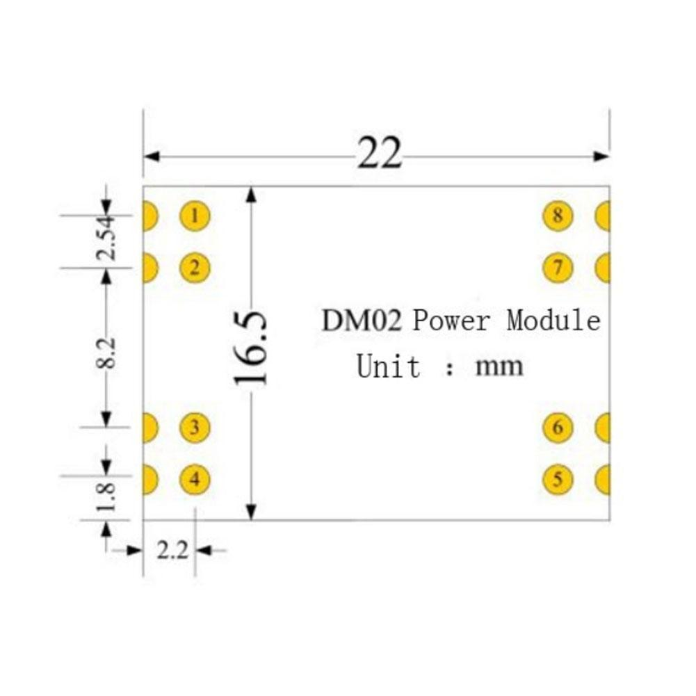
Modules/DC-DC-22-17-Red-footprint.jpg
