andreika-git/deucalion/Modules/DC-DC-22-17-Red-photo02.jpg

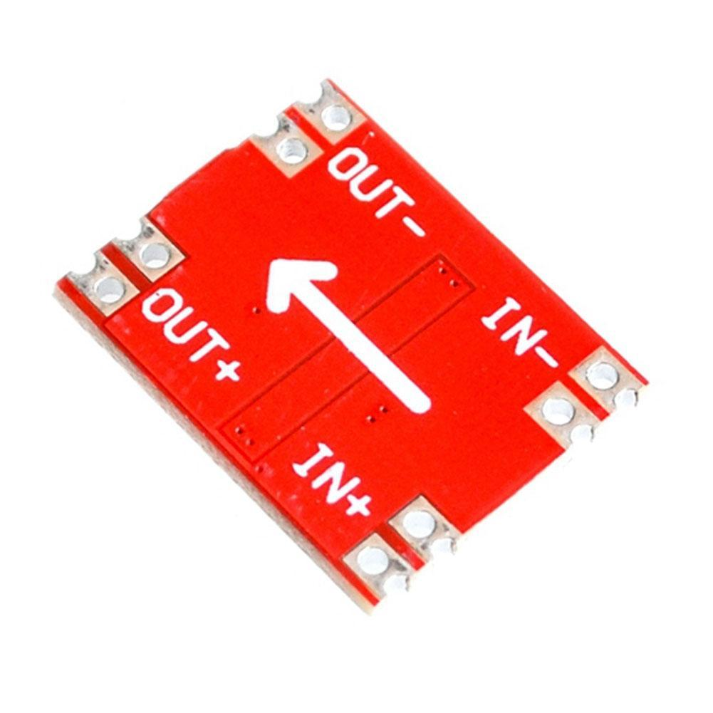
Modules/DC-DC-22-17-Red-photo02.jpg
