andreika-git/deucalion/Modules/DC-DC-24-14-footprint.png

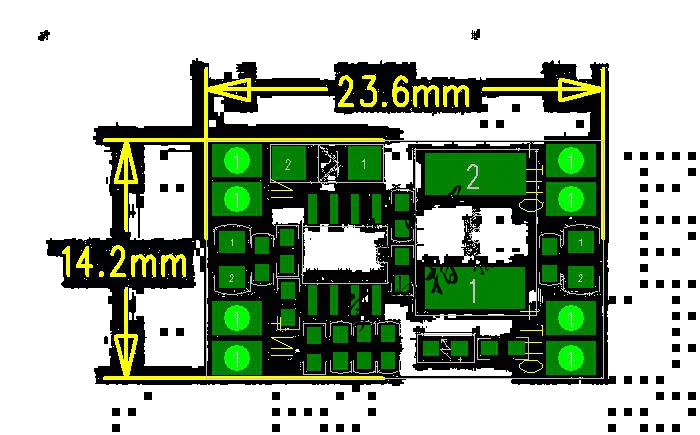
Modules/DC-DC-24-14-footprint.png
