andreika-git/deucalion/Modules/DC-DC-24-14-Yellow-photo02.jpg

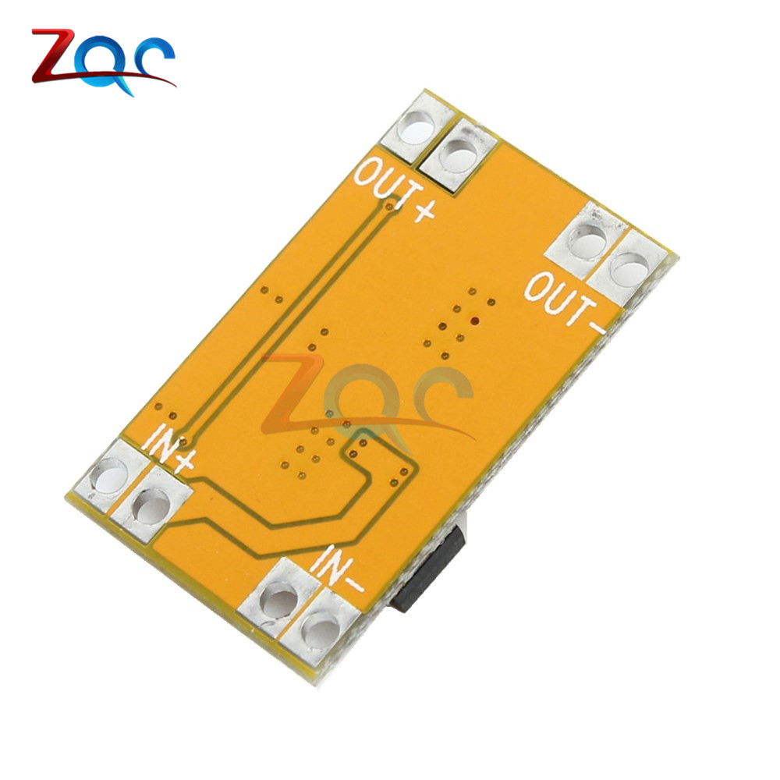
Modules/DC-DC-24-14-Yellow-photo02.jpg
