andreika-git/deucalion/Modules/DC-DC-all-boards.jpg

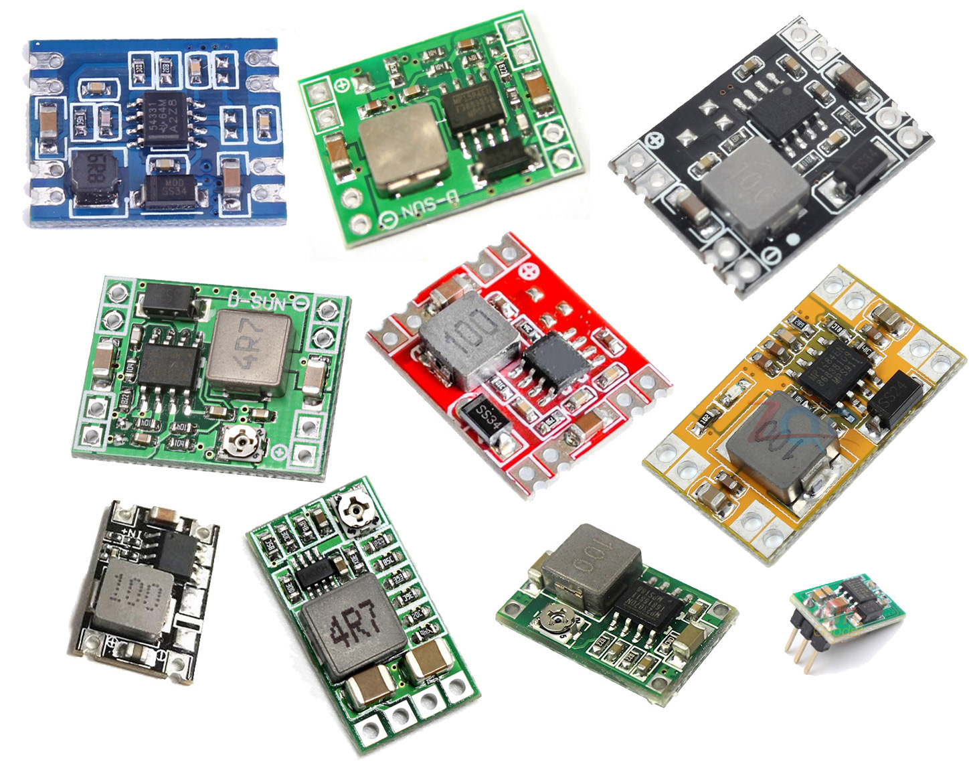
Modules/DC-DC-all-boards.jpg
