andreika-git/deucalion/Modules/DRV8825-photo01.jpg

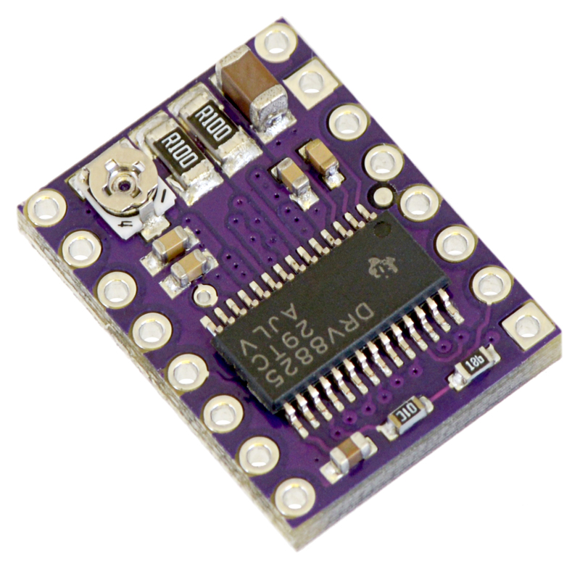
Modules/DRV8825-photo01.jpg
