andreika-git/deucalion/Modules/DRV8825-photo02.jpg

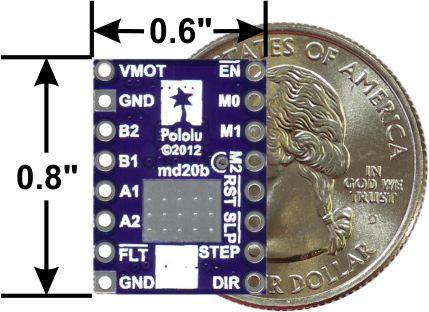
Modules/DRV8825-photo02.jpg
