andreika-git/deucalion/Modules/DRV8825-schem02.png

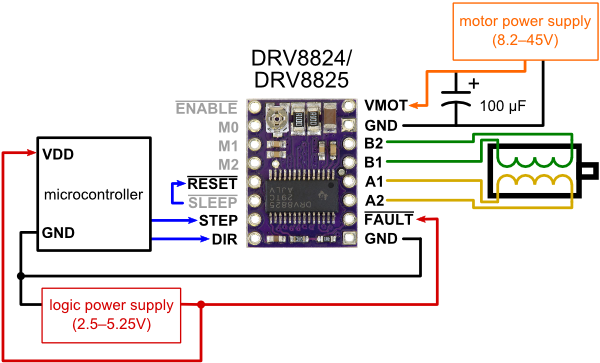
Modules/DRV8825-schem02.png
