andreika-git/deucalion/Modules/LIN/module-lin-screenshot01.png

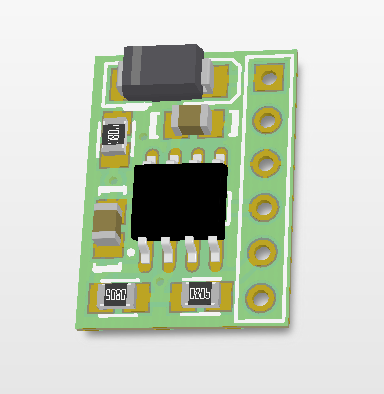
Modules/LIN/module-lin-screenshot01.png
