andreika-git/deucalion/Modules/STM32H743VIT6-mini/STM32H743VIT6-mini1-footprint-schem.webp

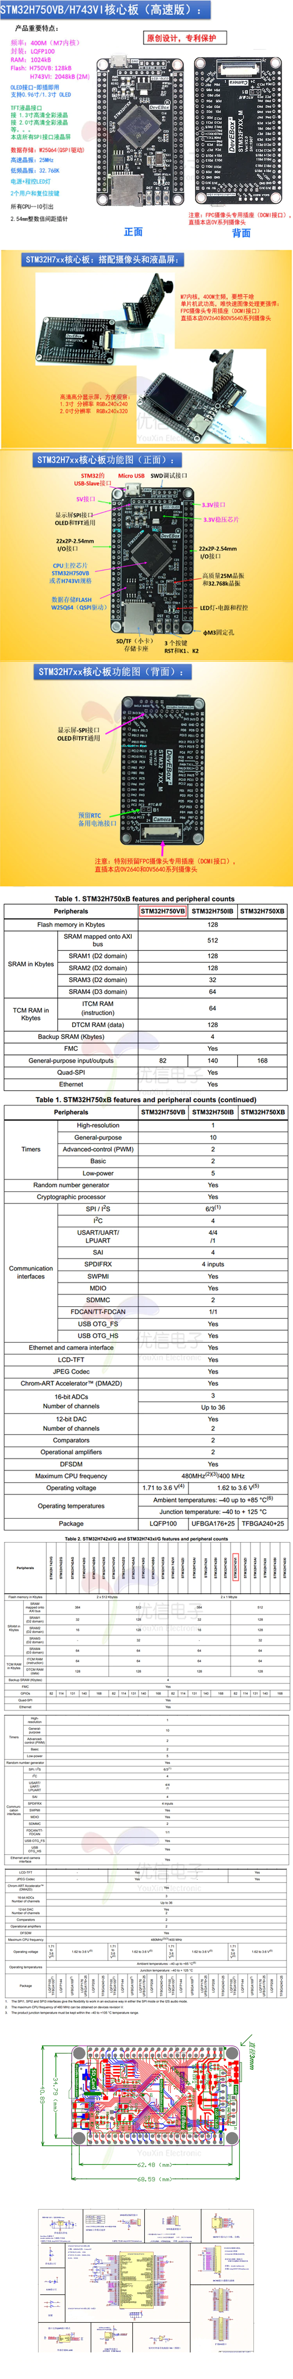
Modules/STM32H743VIT6-mini/STM32H743VIT6-mini1-footprint-schem.webp
