andreika-git/deucalion/Modules/STM32H743VIT6-mini/STM32H743VIT6-mini1-top.jpg

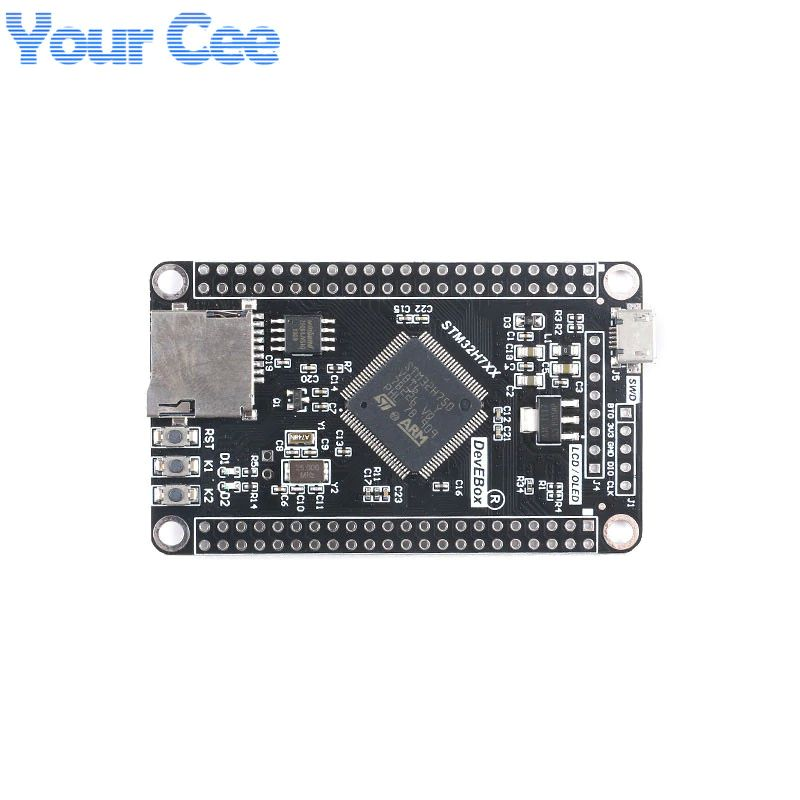
Modules/STM32H743VIT6-mini/STM32H743VIT6-mini1-top.jpg
