andreika-git/deucalion/Modules/STM32H743VIT6-mini/STM32H743VIT6-mini2-bottom.jpg

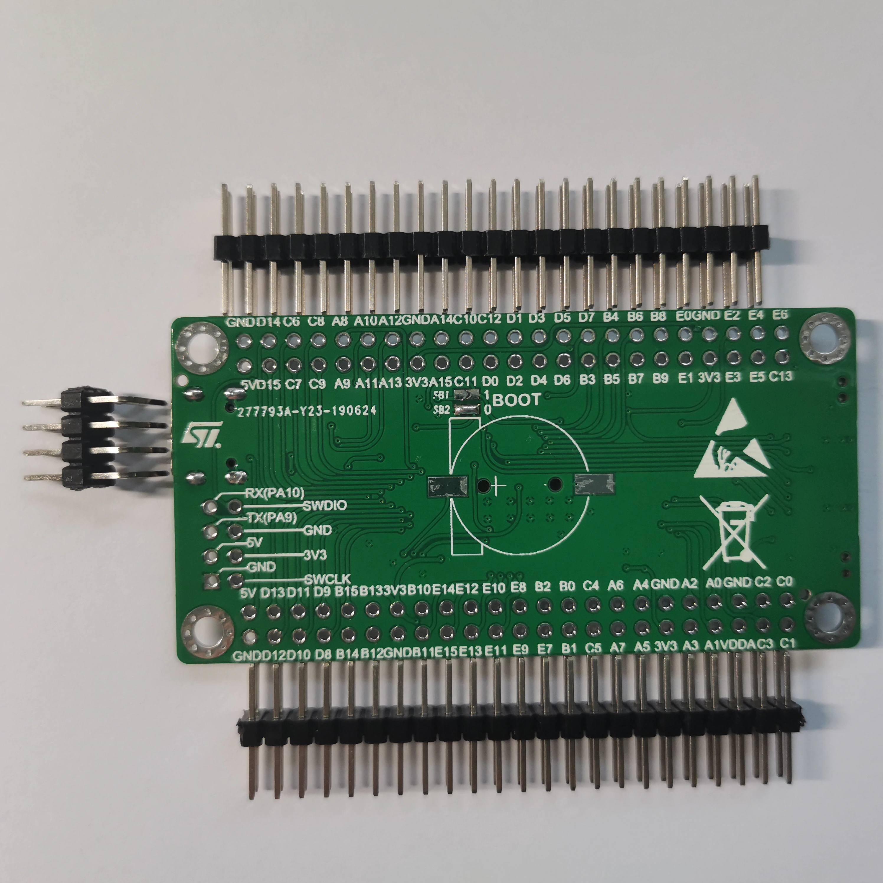
Modules/STM32H743VIT6-mini/STM32H743VIT6-mini2-bottom.jpg
