andreika-git/deucalion/Modules/STM32H743VIT6-mini/STM32H743VIT6-mini3-footprint.jpg

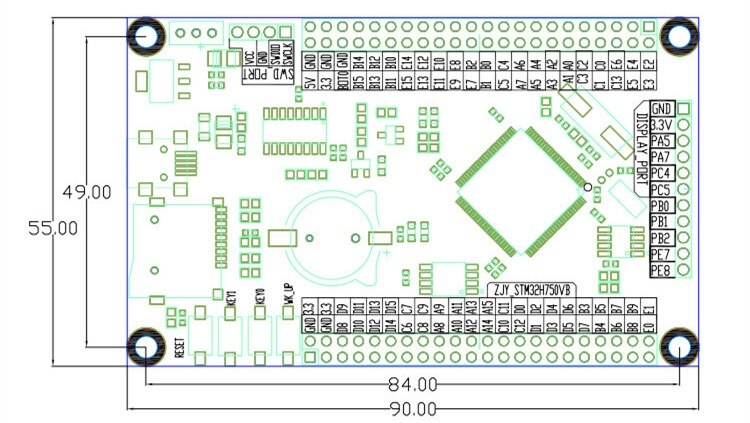
Modules/STM32H743VIT6-mini/STM32H743VIT6-mini3-footprint.jpg
