andreika-git/deucalion/releases/rev.0.1/deucalion_bare_pcb.jpg

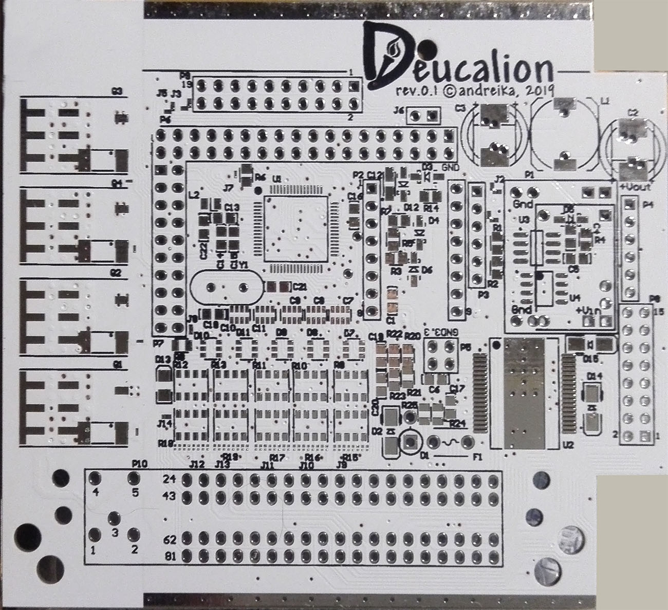
releases/rev.0.1/deucalion_bare_pcb.jpg
