andreika-git/deucalion/sketches/3d_60.PNG

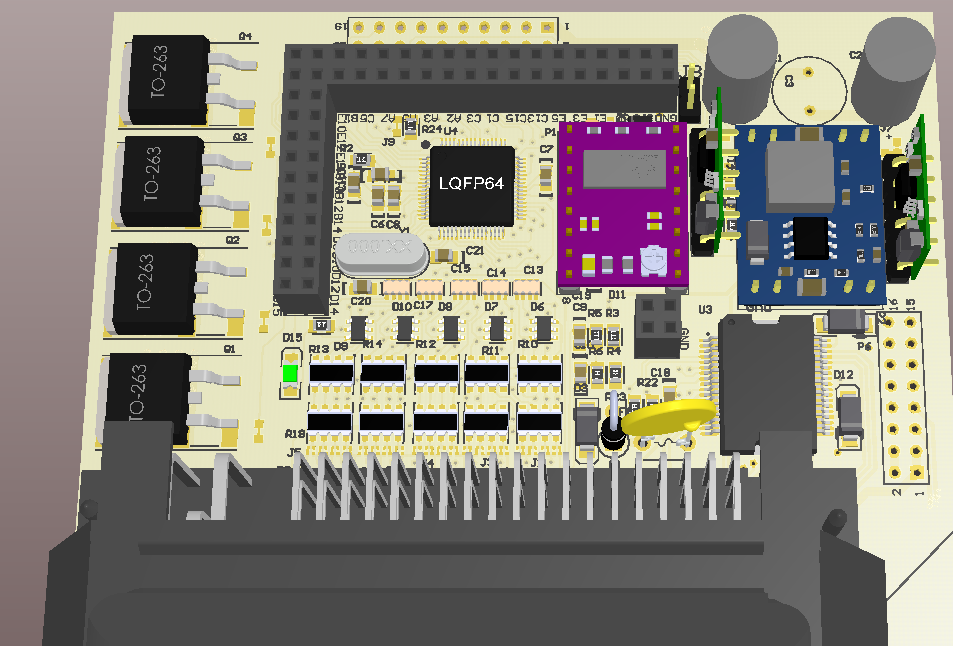
sketches/3d_60.PNG
