andreika-git/deucalion/sketches/3d_91.jpg

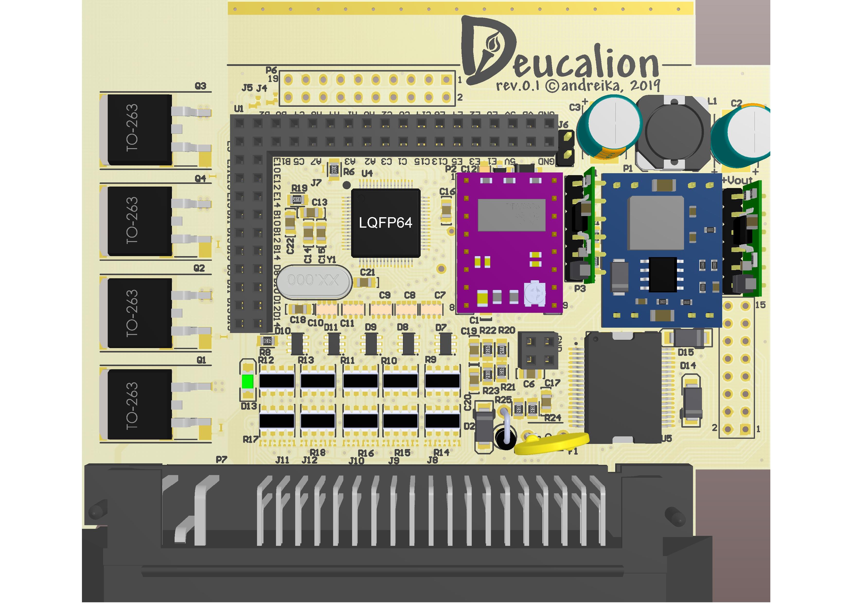
sketches/3d_91.jpg
