andreika-git/deucalion/sketches/3d_91_2.jpg

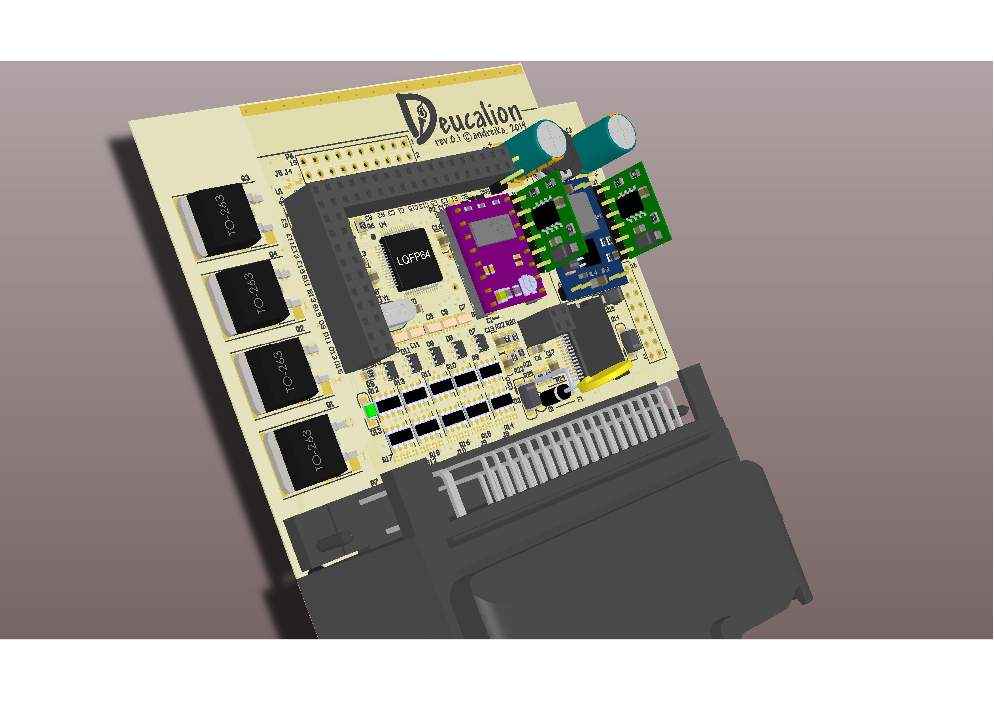
sketches/3d_91_2.jpg
