andreika-git/deucalion/sketches/3d_99.PNG

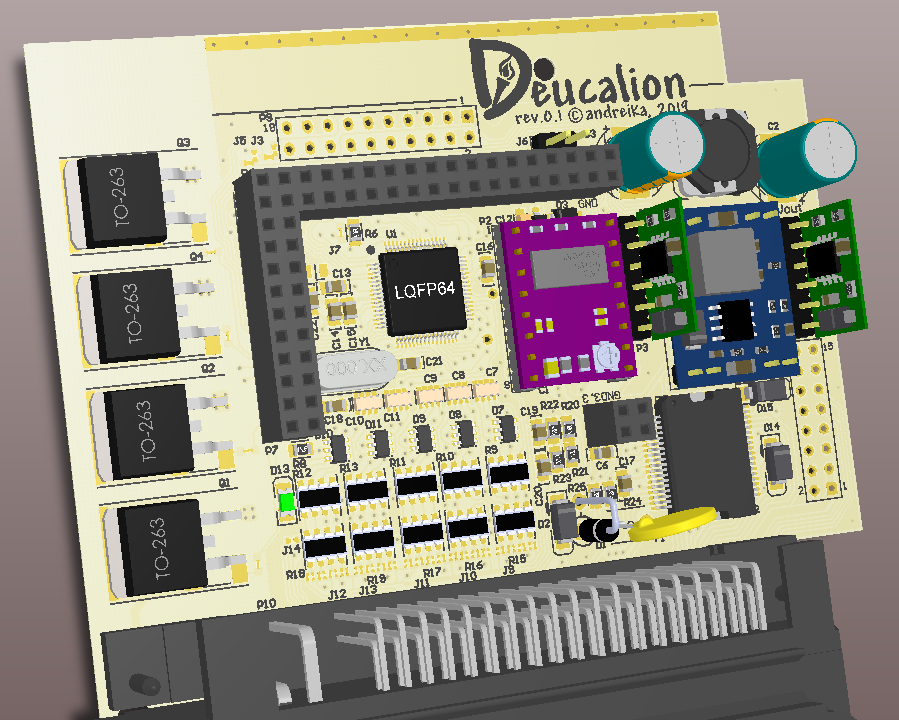
sketches/3d_99.PNG
