andreika-git/deucalion/sketches/layout_30.png

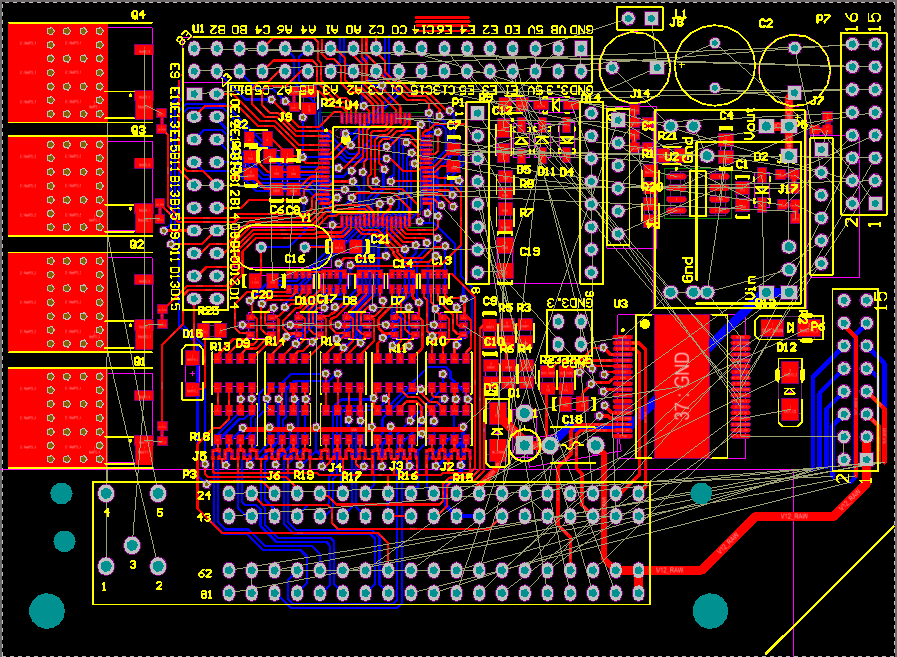
sketches/layout_30.png
