andreika-git/deucalion/sketches/layout_60.PNG

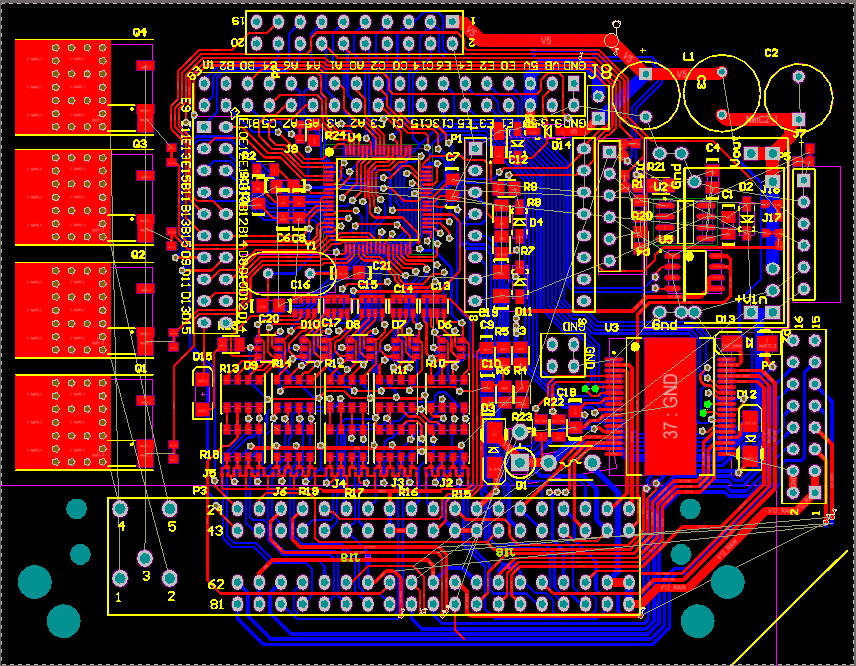
sketches/layout_60.PNG
