andreika-git/deucalion/sketches/layout_91.PNG

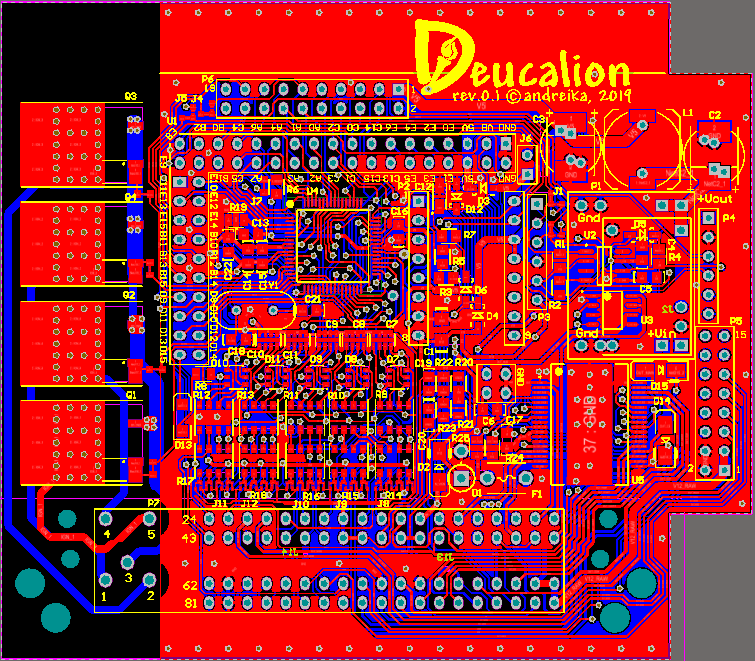
sketches/layout_91.PNG
