andreika-git/deucalion/sketches/layout_91_bottom.PNG

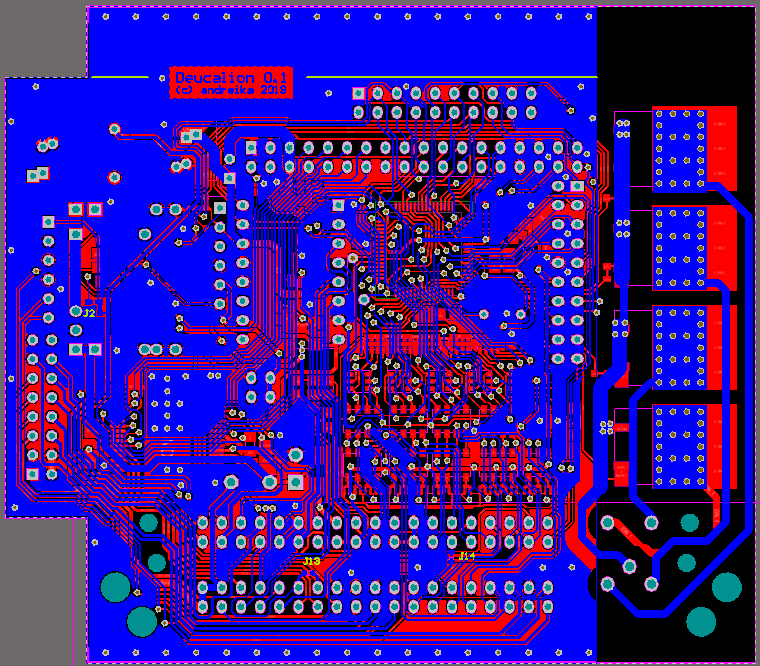
sketches/layout_91_bottom.PNG
