andreika-git/deucalion/sketches/layout_99_bottom.PNG

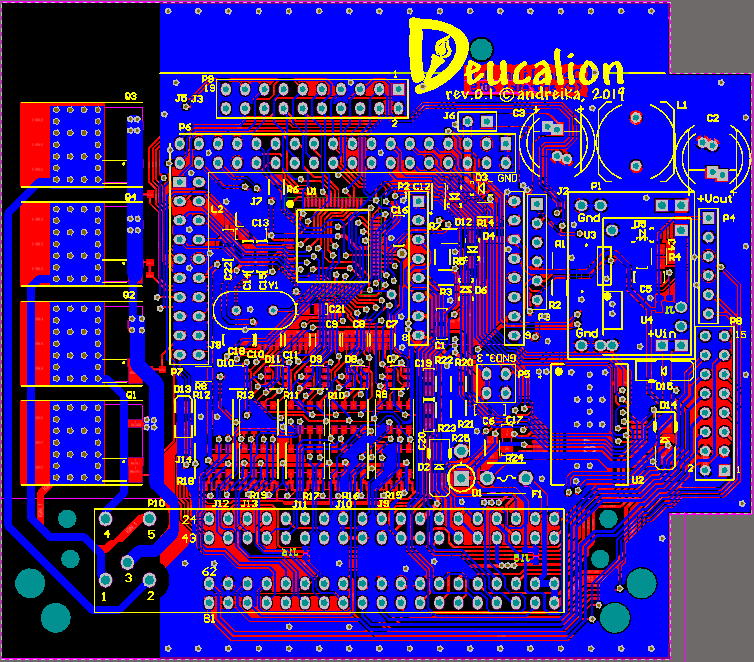
sketches/layout_99_bottom.PNG
