andreika-git/deucalion/sketches/schem_30.png

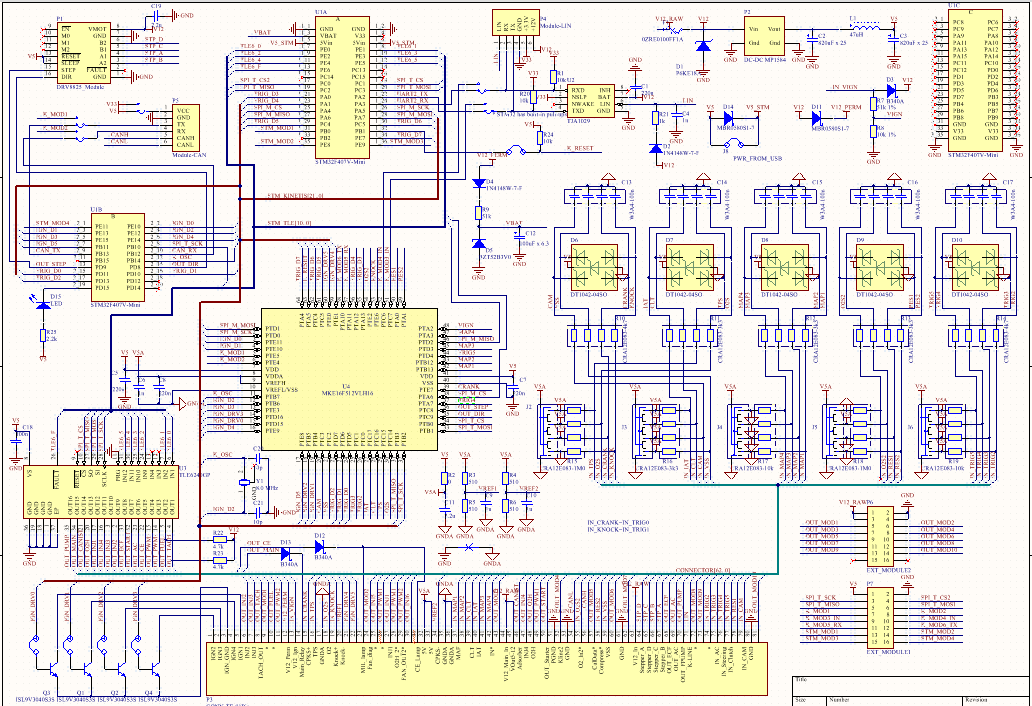
sketches/schem_30.png
