andreika-git/deucalion/sketches/schem_60.PNG

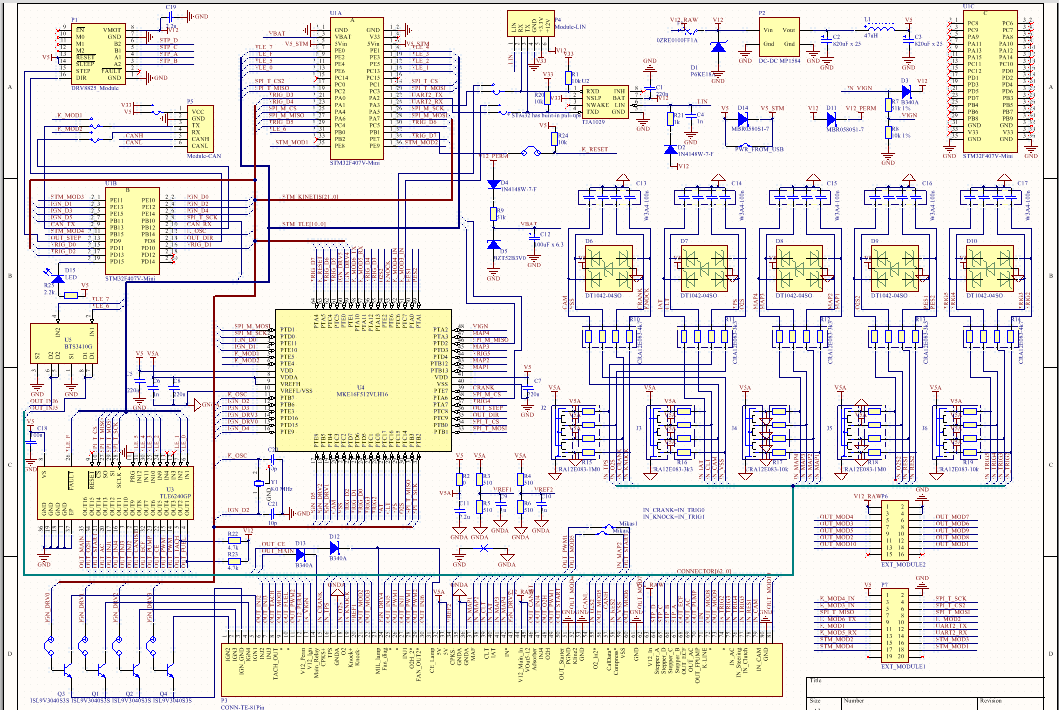
sketches/schem_60.PNG
