andreika-git/deucalion/sketches/schem_91.PNG

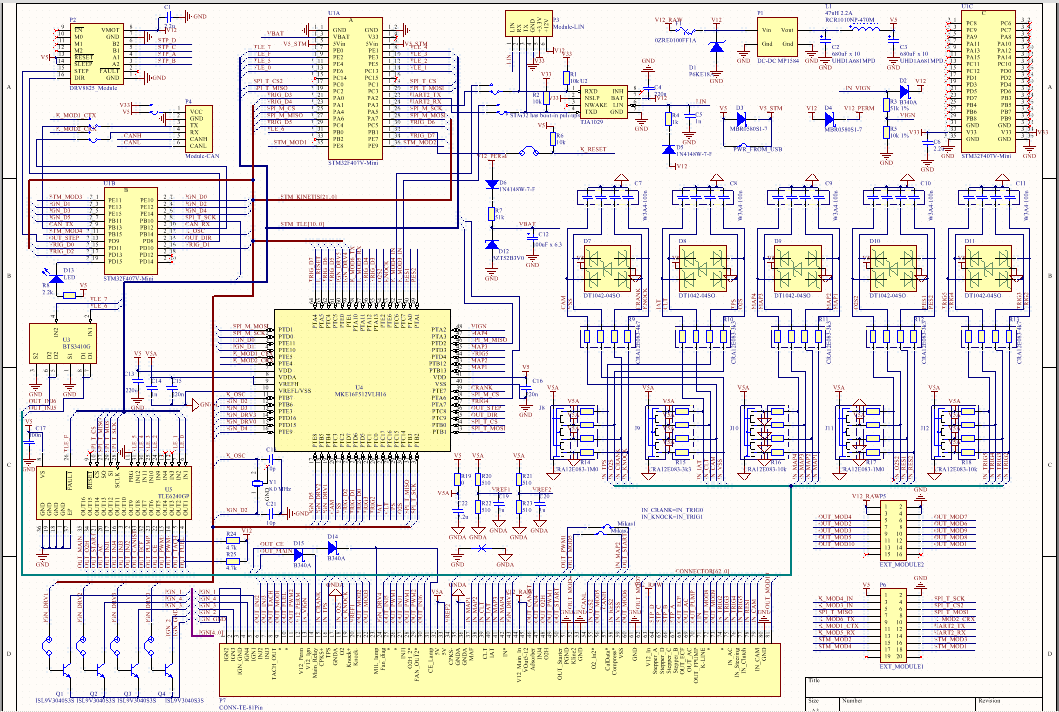
sketches/schem_91.PNG
