andreika-git/deucalion/sketches/schem_99.PNG

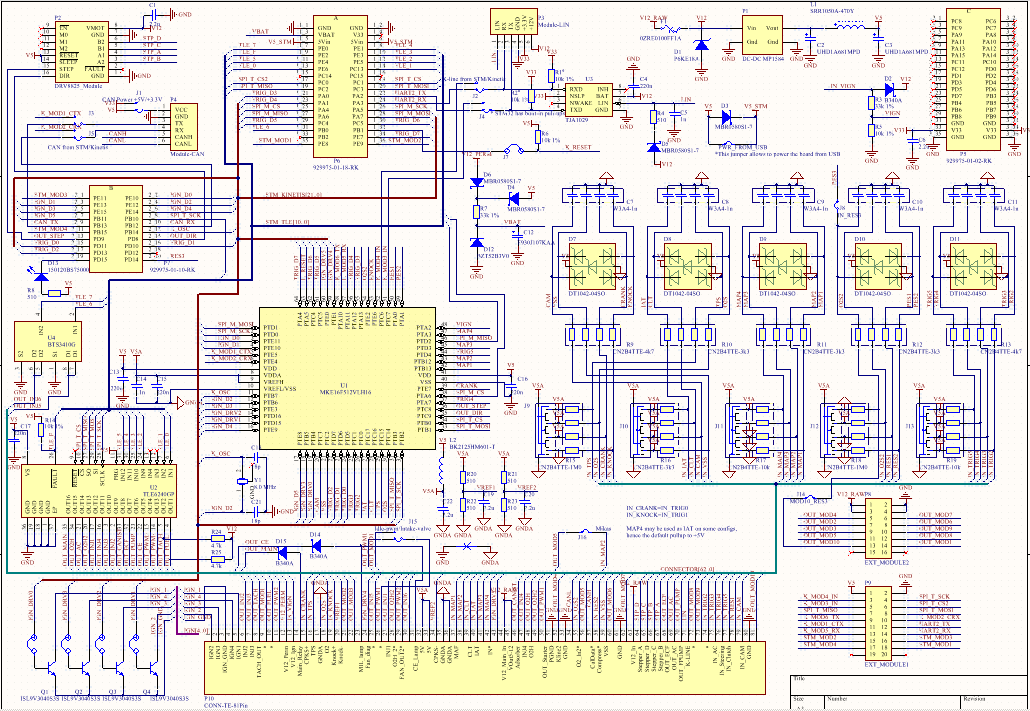
sketches/schem_99.PNG
