andreika-git/deucalion/deucalion_bom.xlsx

Sheet: deucalion
Designator | Part # | Description | Footprint | Quantity 1 | Mouser Part Number | Digi-Key Part Number | Unit Price 1 | Price x Num | Notes
C1, C6, C19, C20, C22 | 2.2u | Capacitor | C0805 | 5 | 710-885012207079 (https://octopart-clicks.com/click/altium?sku=710-885012207079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) | 732-7673-1-ND (https://octopart-clicks.com/click/altium?sku=732-7673-1-ND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) | $0.22 | $1.10
C2, C3 | UHD1A681MPD | Electrolytic or Tantalum Capacitor | CAP R3.5-8.0X12 / TANT-E | 2 | 647-UHD1A681MPD (https://octopart-clicks.com/click/altium?sku=647-UHD1A681MPD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) | 493-16775-ND (https://octopart-clicks.com/click/altium?sku=493-16775-ND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) | $0.49 | $0.98 | Better alternative: T55D337M010C0007 ($2.11)
C4, C13, C15, C16, C17 | 220n | Capacitor | C0805 | 5 | 710-885012207074 (https://octopart-clicks.com/click/altium?sku=710-885012207074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) | 732-7668-1-ND (https://octopart-clicks.com/click/altium?sku=732-7668-1-ND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) | $0.11 | $0.55
C5, C14 | 1n | Capacitor | C0805 | 2 | 710-885012007063 (https://octopart-clicks.com/click/altium?sku=710-885012007063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) | 732-7858-1-ND (https://octopart-clicks.com/click/altium?sku=732-7858-1-ND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) | $0.10 | $0.20
C7, C8, C9, C10, C11 | W3A4-1n | Capacitor Array (4 caps) | C0612-4 | 5 | 581-W3A4YC102KAT2A (https://octopart-clicks.com/click/altium?sku=581-W3A4YC102KAT2A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) | 478-2874-1-ND (https://octopart-clicks.com/click/altium?sku=478-2874-1-ND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) | $0.30 | $1.50
C12 | F930J107KAA | Tantalum Capacitor | TANT-A | 1 | 647-F930J107KAA (https://octopart-clicks.com/click/altium?sku=647-F930J107KAA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) | 478-8152-1-ND (https://octopart-clicks.com/click/altium?sku=478-8152-1-ND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) | $0.54 | $0.54
D1 | P6KE18A | TVS Diode | DO-15 | 1 | 511-P6KE18A | 497-11385-1-ND (https://octopart-clicks.com/click/altium?sku=497-11385-1-ND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) | $0.43 | $0.43
D2, D14, D15 | B340A | Schottky Diode | SMA | 3 | 621-B340A-F (https://octopart-clicks.com/click/altium?sku=621-B340A-F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) | B340A-E3/61TGICT-ND (https://octopart-clicks.com/click/altium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) | $0.43 | $1.29
D3, D6 | MBR0580S1-7 | Schottky Diode | SOD-123 | 2 | 621-MBR0580S1-7 (https://octopart-clicks.com/click/altium?sku=621-MBR0580S1-7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) | MBR0580S1-7DICT-ND (https://octopart-clicks.com/click/altium?sku=MBR0580S1-7DICT-ND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) | $0.28 | $0.56
D7, D8, D9, D10, D11 | DT1042-04SO | TVS Diode Array | SOT-26 | 5 | 621-DT1042-04SO-7 (https://octopart-clicks.com/click/altium?sku=621-DT1042-04SO-7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) | DT1042-04SO-7DICT-ND (https://octopart-clicks.com/click/altium?sku=DT1042-04SO-7DICT-ND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) | $0.42 | $2.10
D12 | BZT52B3V0 | Zener Diode | SOD-123 | 1 | 771-BZT52-B3V0J (https://octopart-clicks.com/click/altium?sku=771-BZT52-B3V0J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) | 1727-8113-1-ND (https://octopart-clicks.com/click/altium?sku=1727-8113-1-ND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) | $0.23 | $0.23
D13 | 150120BS75000 | LED BLUE 1206 | LED-1206 | 1 | 710-150120BS75000 (https://octopart-clicks.com/click/altium?sku=710-150120BS75000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) | 732-4989-1-ND (https://octopart-clicks.com/click/altium?sku=732-4989-1-ND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) | $0.21 | $0.21
F1 | 0ZRE0100FF1A | Thermal Polyswitch Fuse | PTC-5.1-10 | 1 | 530-0ZRE0100FF1A (https://octopart-clicks.com/click/altium?sku=530-0ZRE0100FF1A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) | 507-2077-ND (https://octopart-clicks.com/click/altium?sku=507-2077-ND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) | $0.72 | $0.72
L1 | SRR1050A-470Y | Inductor with Ferrite Core | L R6.4-10.5 / SMD | 1 | 652-SRR1050A-470Y (https://octopart-clicks.com/click/altium?sku=652-SRR1050A-470Y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) | SRR1050A-470YCT-ND (https://octopart-clicks.com/click/altium?sku=SRR1050A-470YCT-ND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) | $0.87 | $0.87 | Alternative: RCR1010NP-470M
L2 | Chip Inductor | BK2125HM601-T | L0805 | 1 | 963-BK2125HM601-T (https://octopart-clicks.com/click/altium?sku=963-BK2125HM601-T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) | 587-1902-1-ND (https://octopart-clicks.com/click/altium?sku=587-1902-1-ND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) | $0.10 | $0.10
P5 | 929975-01-02-RK | STM32F407V-Mini 2x2 Connector #3 | Female-pin-header-2.54-2x2 | 1 | 517-929975-01-02-RK (https://octopart-clicks.com/click/altium?sku=517-929975-01-02-RK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) | 929975E-01-02-ND (https://octopart-clicks.com/click/altium?sku=929975E-01-02-ND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) | $1.42 | $1.42 | Alternative: SSW10201FD (gold-plated)
P6 | 929975-01-18-RK | STM32F407V-Mini 2x18 Connector #1 | Female-pin-header-2.54-2x18 | 1 | 517-929975-01-18-RK (https://octopart-clicks.com/click/altium?sku=517-929975-01-18-RK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) | 929975E-01-18-ND (https://octopart-clicks.com/click/altium?sku=929975E-01-18-ND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) | $2.60 | $2.60 | Alternative: SSW11801FD (gold-plated)
P7 | 929975-01-10-RK | STM32F407V-Mini 2x10 Connector #2 | Female-pin-header-2.54-2x10 | 1 | 517-929975-01-10-RK (https://octopart-clicks.com/click/altium?sku=517-929975-01-10-RK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) | 929975E-01-10-ND (https://octopart-clicks.com/click/altium?sku=929975E-01-10-ND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) | $2.03 | $2.03 | Alternative: SSW11001FD (gold-plated)
Q1, Q2, Q3, Q4 | ISL9V3040S3S | IGBT Transistor | D2PAK | 4 | 512-ISL9V3040S3ST (https://octopart-clicks.com/click/altium?sku=512-ISL9V3040S3ST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) | ISL9V3040S3STTR-ND (https://octopart-clicks.com/click/altium?sku=ISL9V3040S3STTR-ND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) | $2.01 | $8.04 | Replaced with CRGCQ2512J10R for logic-level COPs
R5 | 10k 1% | Resistor | R0805 | 1 | 667-ERJ-6ENF1002V | P10.0KCCT-ND | $0.10 | $0.10
R3, R7 | 33k 1% | Resistor | R0805 | 2 | 667-ERJ-6ENF3302V | P33.0KCCT-ND | $0.10 | $0.20
R8,R20, R21, R22, R23 | 510 | Resistor | R0805 | 5 | 667-ERJ-6ENF5100V | P510CCT-ND | $0.10 | $0.50
R9, R13 | CN2B4TTE-4k7 | Resistor Array (4 res) | CRA12E08 | 2 | 660-CN2B4TTE472J (https://octopart-clicks.com/click/altium?sku=660-CN2B4TTE472J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) | 744C083472JPCT-ND (https://octopart-clicks.com/click/altium?sku=744C083472JPCT-ND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) | $0.15 | $0.30 | Alt: 744C083472JP, CRA12E-J-4.7K
R10, R11, R12, R16 | CN2B4TTE-3k3 | Resistor Array (4 res) | CRA12E08 | 4 | 660-CN2B4TTE332J (https://octopart-clicks.com/click/altium?sku=660-CN2B4TTE332J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) | 744C083332JPCT-ND (https://octopart-clicks.com/click/altium?sku=744C083332JPCT-ND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) | $0.16 | $0.64 | Alt: 744C083332JP, CRA12E-J-3.3K
R15, R18 | CN2B4TTE-1M0 | Resistor Array (4 res) | CRA12E08 | 2 | 660-CN2B4TTE105J (https://octopart-clicks.com/click/altium?sku=660-CN2B4TTE105J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) | 744C083105JPCT-ND (https://octopart-clicks.com/click/altium?sku=744C083105JPCT-ND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) | $0.16 | $0.32 | Alt: 744C083105JP, CRA12E-J-1M
R17, R19 | CN2B4TTE-10k | Resistor Array (4 res) | CRA12E08 | 2 | 660-CN2B4TTE103J (https://octopart-clicks.com/click/altium?sku=660-CN2B4TTE103J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) | 744C083103JPCT-ND (https://octopart-clicks.com/click/altium?sku=744C083103JPCT-ND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) | $0.15 | $0.30 | Alt: 744C083103JP, CRA12E-F-10K
R24, R25 | 4.7k | Resistor | R0805 | 2 | 667-ERJ-6ENF4701V | P4.70KCCT-ND | $0.10 | $0.20
U1 | MKE16F512VLH16 | NXP Kinetis KE1xF Cortex-M4 MCU | LQFP64 | 1 | 841-MKE16F512VLH16 (https://octopart-clicks.com/click/altium?sku=841-MKE16F512VLH16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) | 568-14459-ND (https://octopart-clicks.com/click/altium?sku=568-14459-ND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) | $7.05 | $7.05
U2 | TLE6240GP | Smart 16 Channel Low Side Switch | PG-DSO-36-26 | 1 | 726-TLE6240GP (https://octopart-clicks.com/click/altium?sku=726-TLE6240GP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) | TLE6240GPAUMA1CT-ND (https://octopart-clicks.com/click/altium?sku=TLE6240GPAUMA1CT-ND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) | $8.68 | $8.68
U3 | TJA1029 | LIN K-Line Transceiver | SO8 | 1 | 771-TJA1029T/20/1 (https://octopart-clicks.com/click/altium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) | 568-14409-1-ND (https://octopart-clicks.com/click/altium?sku=568-14409-1-ND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) | $0.91 | $0.91
U4 | BTS3410G | Smart Low-Side Power Switch HITFET, 42 V VDS, 1.3 A ID, -40 to 150 degC, PG-DSO-8-25, Reel, Green | PG-DSO-8-25 | 1 | 726-BTS3410G (https://octopart-clicks.com/click/altium?sku=726-BTS3410G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) | BTS3410GTR-ND (https://octopart-clicks.com/click/altium?sku=BTS3410GTR-ND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) | $1.54
Y1 | 8.0 MHz | Crystal Oscillator (SMD, TH) | HC49 | 1 | 774-ATS08A-E | CTX1054-ND | $0.36
D4, D5 | MBR0580S1-7 | Schottky Diode | SOD-123 | 2 | 621-MBR0580S1-7 (https://octopart-clicks.com/click/altium?sku=621-MBR0580S1-7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) | MBR0580S1-7DICT-ND (https://octopart-clicks.com/click/altium?sku=MBR0580S1-7DICT-ND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) | $0.28
C18, C21 | 10p | Capacitor | C0805 | 2 | 710-885012007076 | 732-12223-1-ND | $0.10
R1, R2. R6 | 10k 1% | Resistor | R0805 | 3 | 667-ERJ-6ENF1002V | P10.0KCCT-ND | $0.10
R4 | 510 | Resistor | R0805 | 1 | 667-ERJ-6ENF5100V | P510CCT-ND | $0.10
R14 | 10k 1% | Resistor | R0805 | 1 | 667-ERJ-6ENF1002V | P10.0KCCT-ND | $0.10
TOTAL: |  |  |  | 66 |  |  |  | $44.67

Sheet: Лист1
 | pcbway assembly parts estimate:
smt: | 3 | 3 | ic
 | 4 | 10 | res4
 | 1 | 5 | cap4
 | 1 | 5 | tvs4
 | 2 | 6 | diodes
 | 1 | 1 | diode
th: | 3 | 3
 | unique parts:
 | 15 | 33 | (=$93 for 5pcs total)
