andreika-git/deucalion/deucalion-bom.png

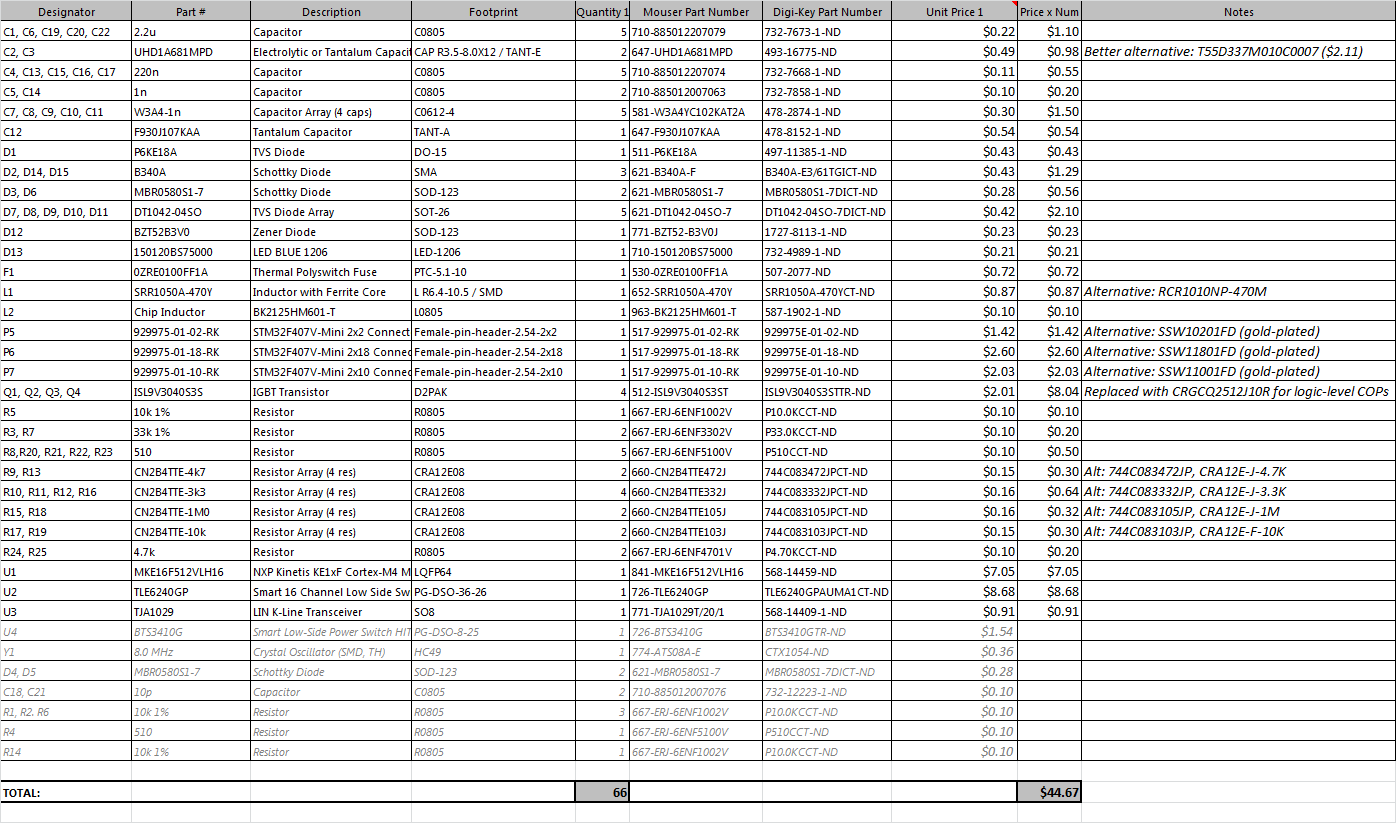
deucalion-bom.png
