andreika-git/deucalion/releases/rev.0.1/deucalion_assembled_pcb.jpg

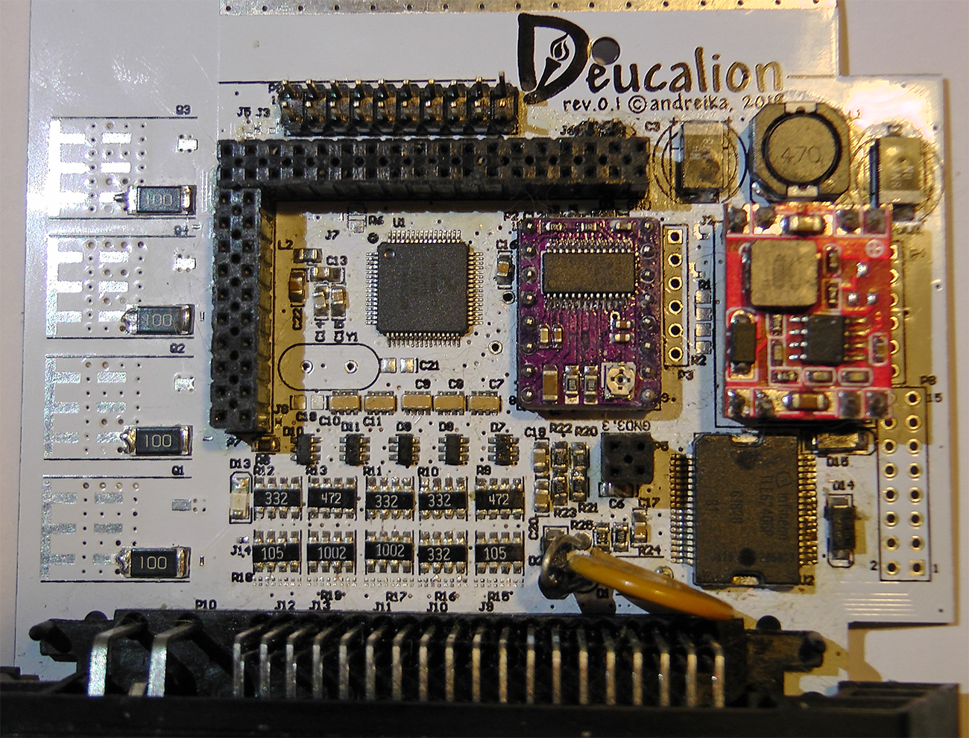
releases/rev.0.1/deucalion_assembled_pcb.jpg
