andreika-git/deucalion/Modules/dc-dc-tests.xlsx

Title: | yellow | black | green | red | blue | tiny green (w/pins) | small green
Vout (no load), V: | 5.15 | 5.09 | 5.09 | 4.99 | 5.01 | 4.93 | 4.97
Noise level (no load), mV: | 20 | 40 | 20 | 50 | 15 | 20 | 40
Vout (load 1A), V: | 5.14 | 5.1 | 5.28 | 5 | 5 | 4.9 | 4.93
Noise level (load 1A), mV: | 20 | 25 | 950 | 12 | 640 | 32 | 450
Noise freq, kHz: | 330 | 350 | 125 | 370 | 100 | ? | 100
Input current (load 1A), mA: | 470 | 477 | 557 | 460 | 471 | 431 | 460
Estimated Efficiency, %: | 89 | 87 | 75 | 91 | 88 | 97 | 91
Notes: | slightly warm, | noise peaks | getting hot | the best? | warm, noisy | not bad | noisy, needs soldering
 | output > 5V | (no load) |  |  | pinout inverted!
