andreika-git/deucalion/sketches/3d_test2.jpg

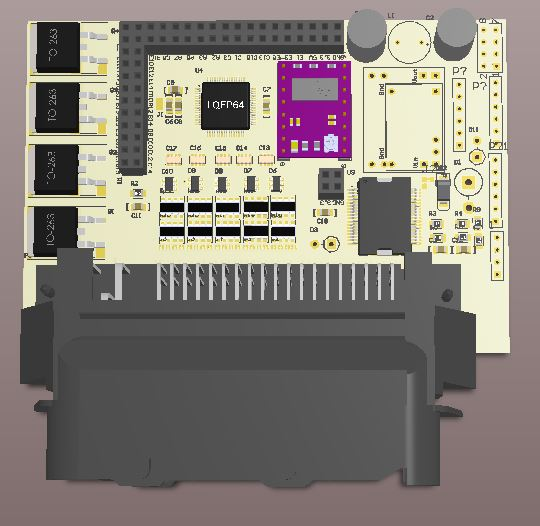
sketches/3d_test2.jpg
