andreika-git/deucalion/sketches/layout_test1.jpg

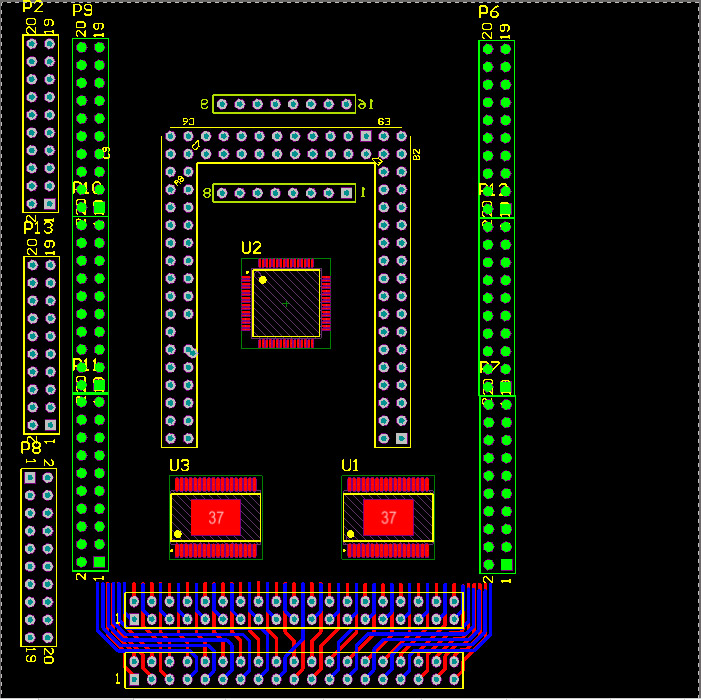
sketches/layout_test1.jpg
