andreika-git/deucalion/sketches/layout_test2.PNG

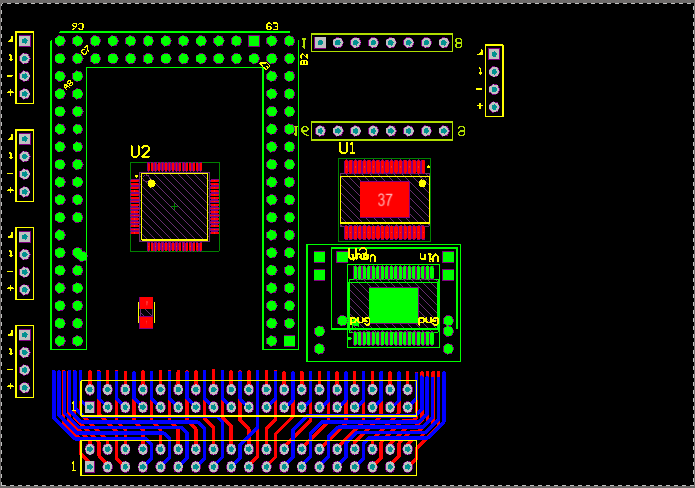
sketches/layout_test2.PNG
