andreika-git/deucalion/sketches/layout_test3.PNG

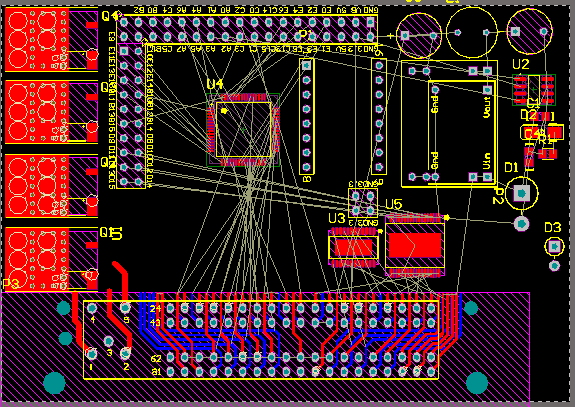
sketches/layout_test3.PNG
