andreika-git/deucalion/sketches/layout_test4.PNG

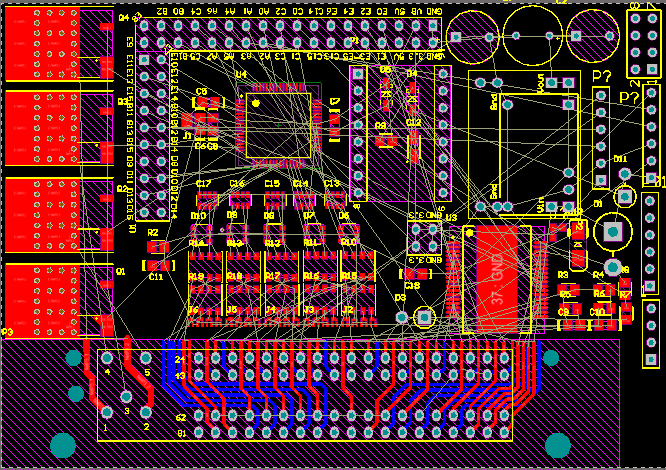
sketches/layout_test4.PNG
