andreika-git/deucalion/sketches/schem_test1.PNG

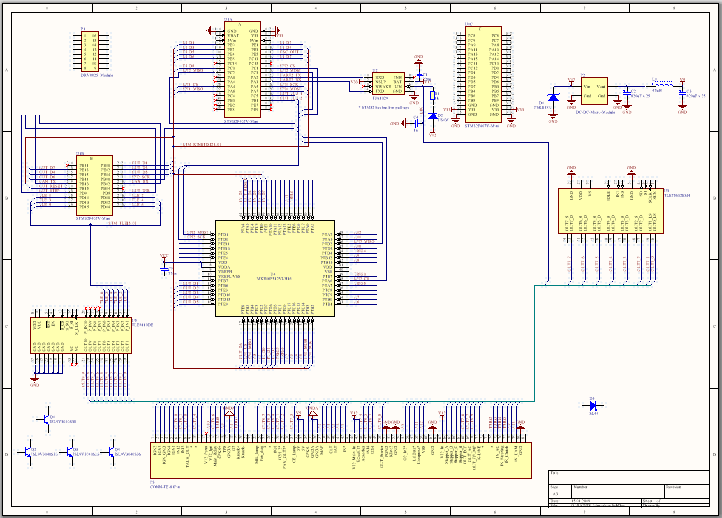
sketches/schem_test1.PNG
