andreika-git/deucalion/sketches/schem_test2.PNG

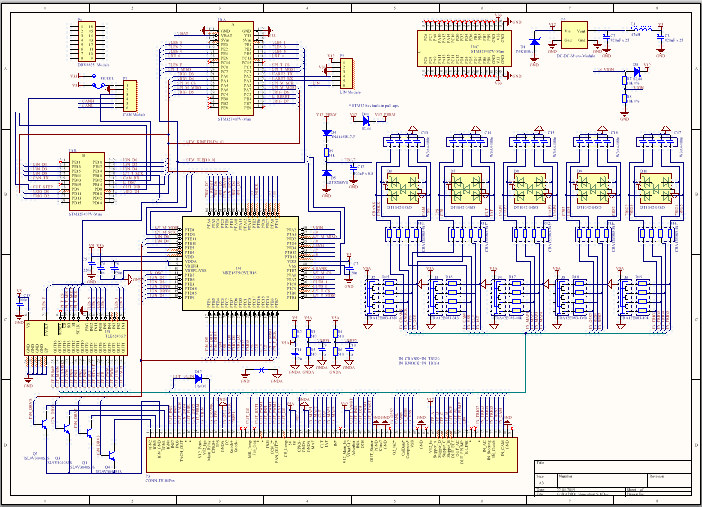
sketches/schem_test2.PNG
