andreika-git/deucalion/releases/rev.0.1/deucalion_schematic_20190213.pdf

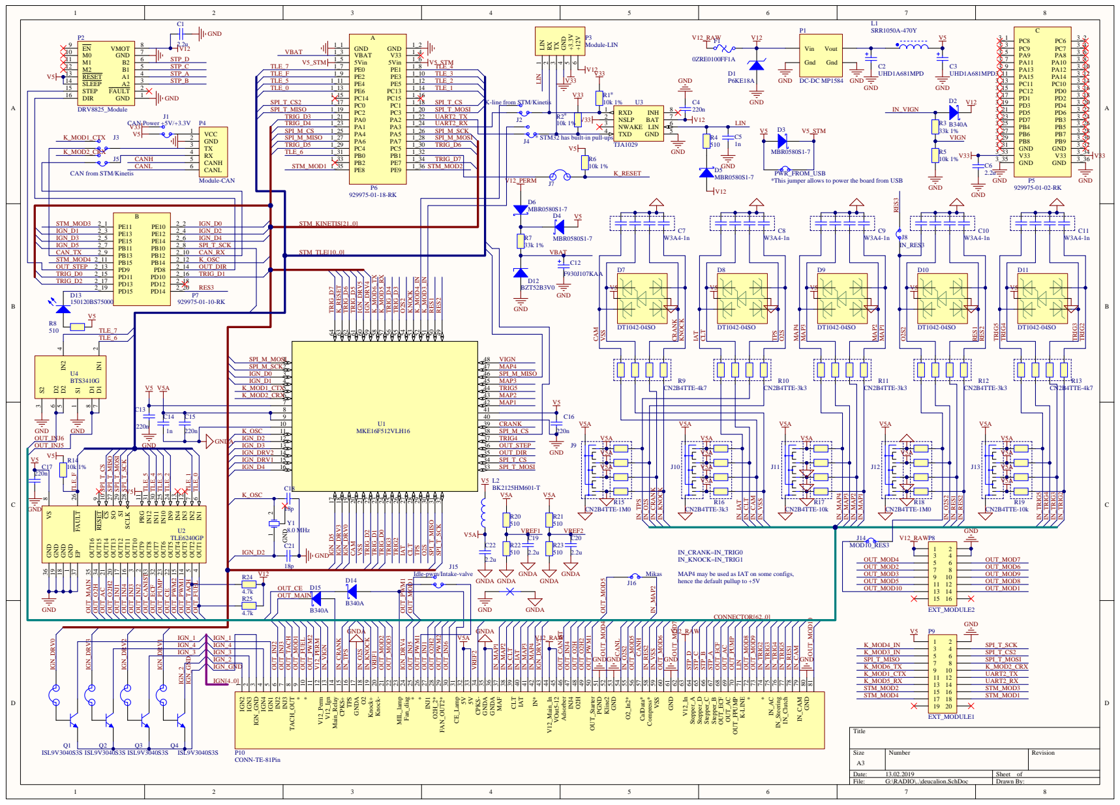
[picture p126: page 1]

K-line from STM/Kinetis

* STM32 has built-in pull-ups

CAN from STM/Kinetis

PWR_FROM_USB
*This jumper allows to power the board from USB

Idle-pwm/Intake-valve

MAP4 may be used as IAT on some configs,
hence the default pullup to +5V
