andreika-git/deucalion/pdf/footprints/PG-DSO-36-26.pdf

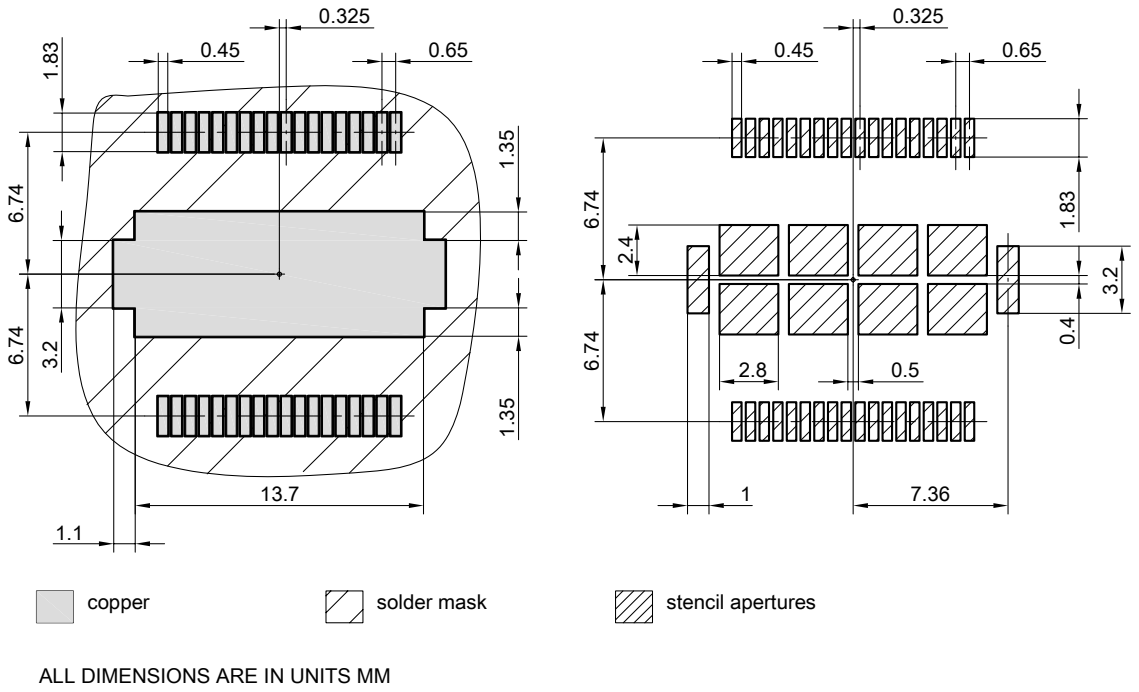
[picture p127: page 1]
copper; solder mask; stencil apertures

ALL DIMENSIONS ARE IN UNITS MM
