andreika-git/deucalion/pdf/footprints/PG-DSO-36-72.pdf

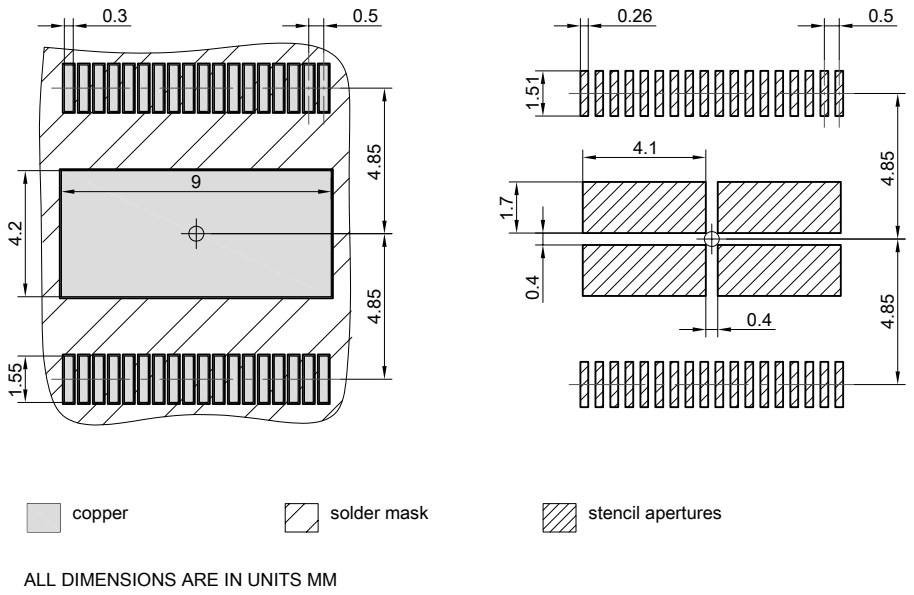
[picture p128: page 1]
copper; solder mask; stencil apertures

ALL DIMENSIONS ARE IN UNITS MM
