andreika-git/deucalion/pdf/footprints/PG-TSDSO-24-21.pdf

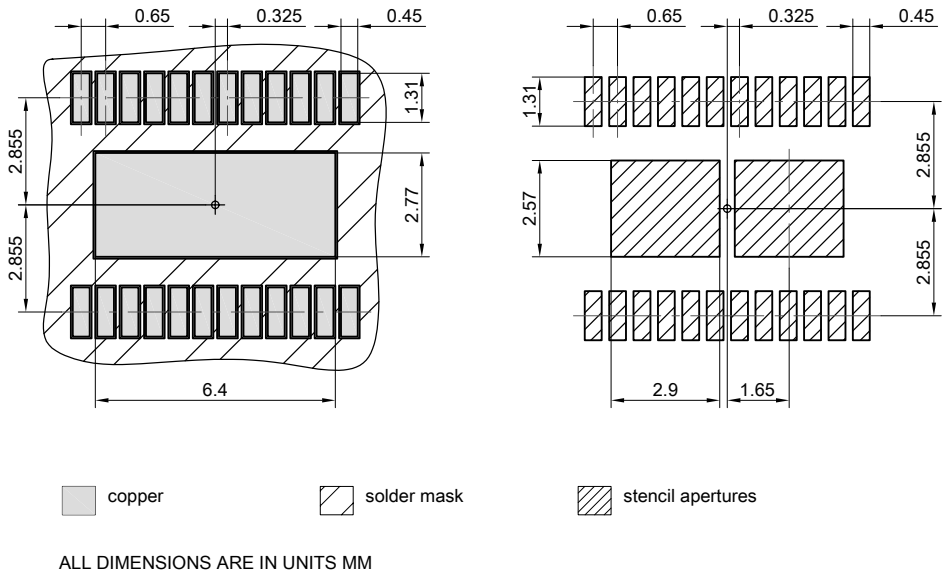
[picture p129: page 1]
copper; solder mask; stencil apertures

ALL DIMENSIONS ARE IN UNITS MM
