andreika-git/deucalion/Connectors/TE_368255-1_121p.pdf

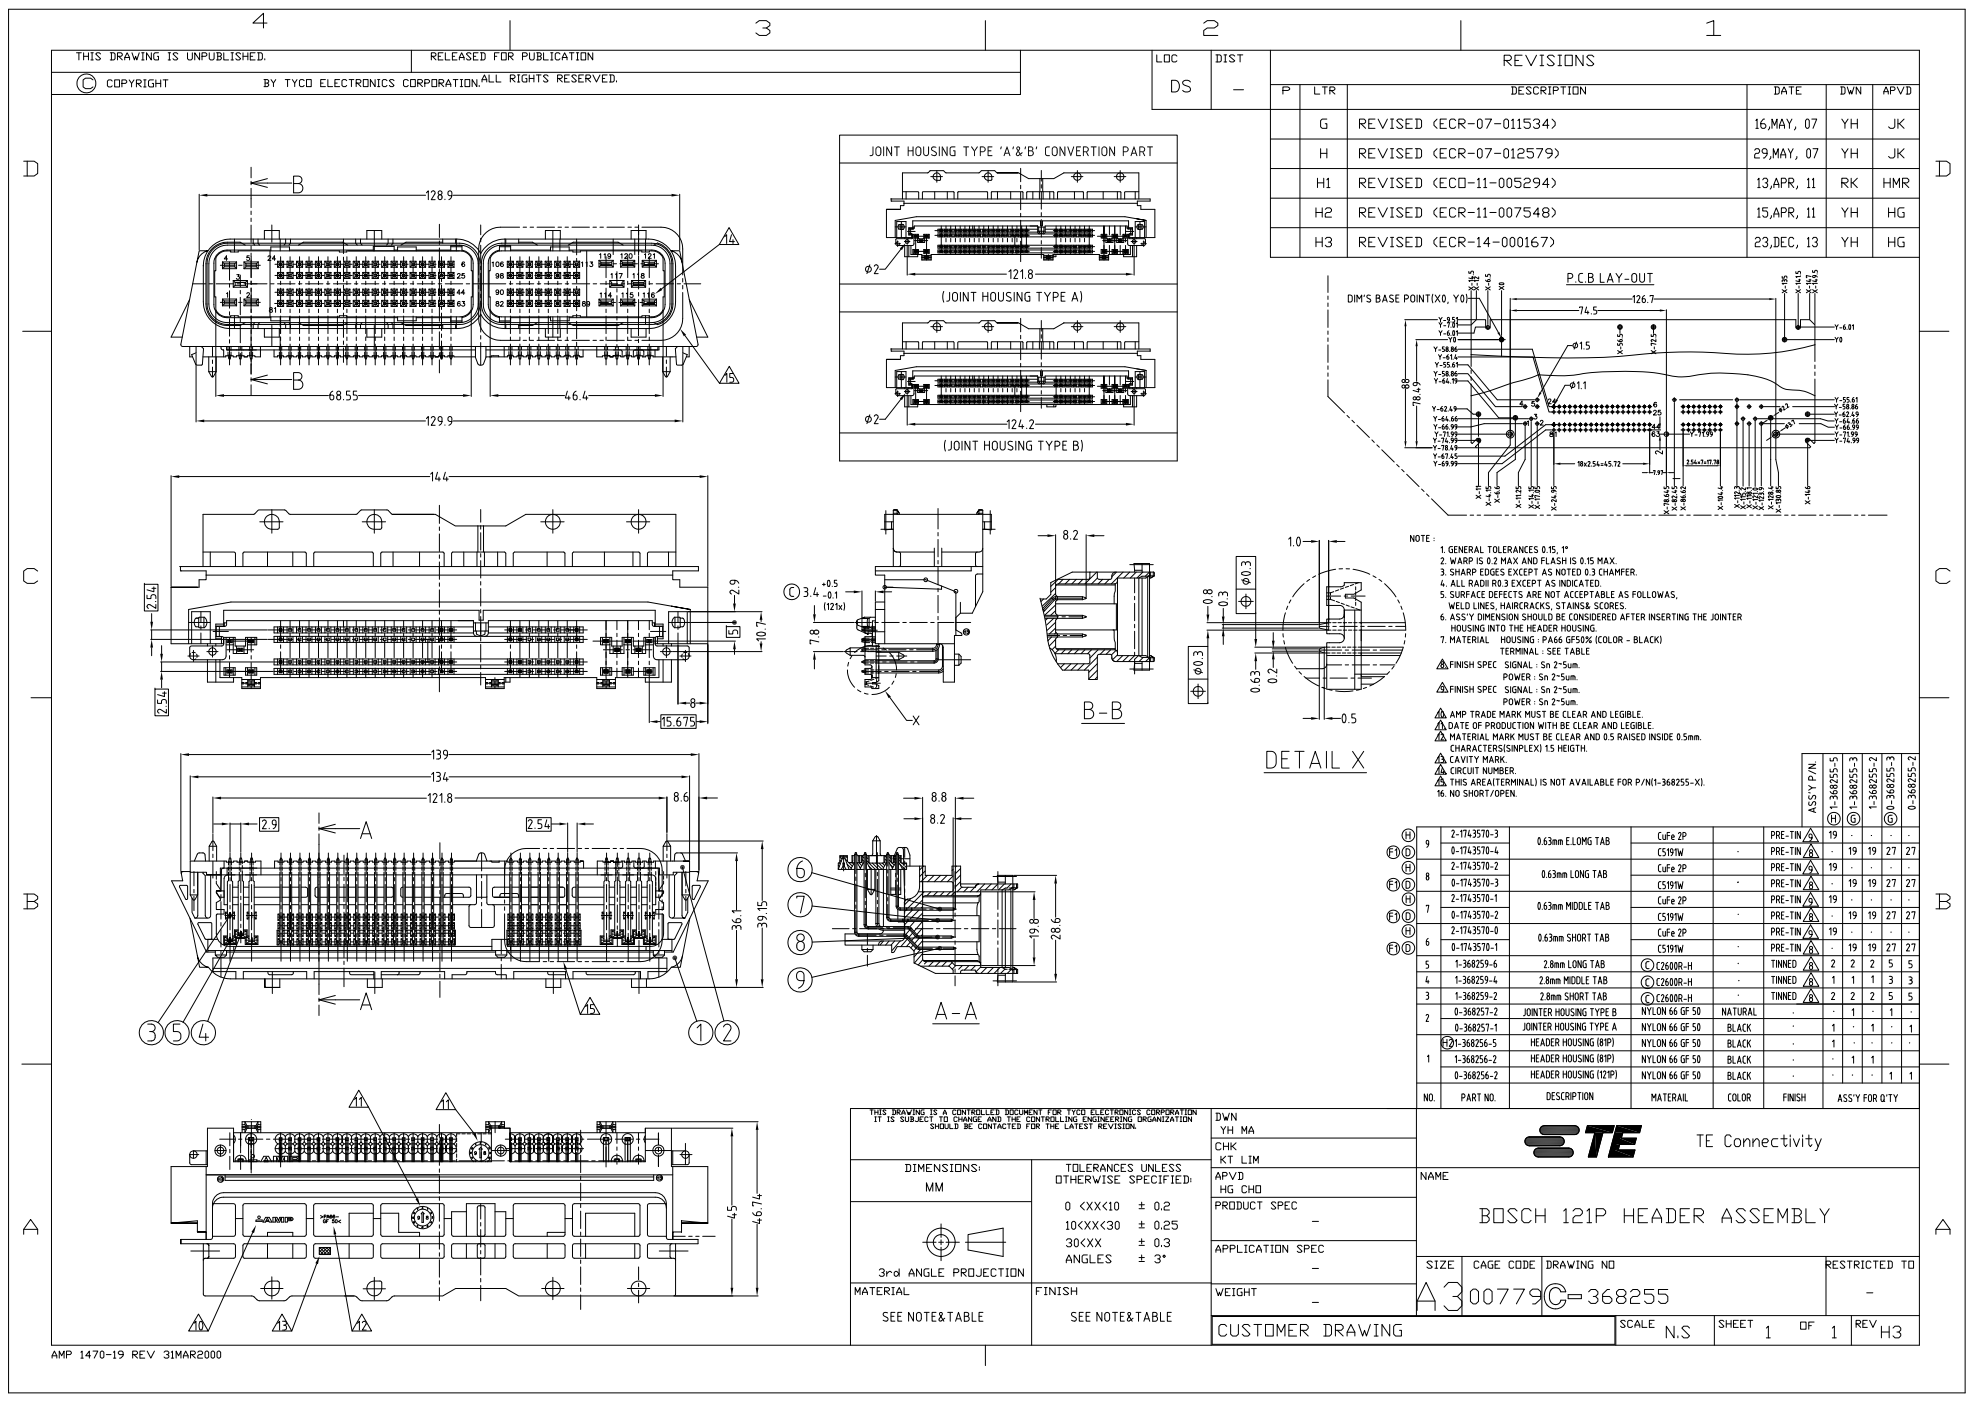
[picture p130: page 1]
