andreika-git/deucalion/(list of files, drawings)

Other design files:
Modules/STM32F407VET6-mini/src/STM32F407VET6mini-PCB.PcbDoc
Modules/STM32F407VET6-mini/src/STM32F407VET6mini-PCB.PcbLib
Modules/STM32F407VET6-mini/src/STM32F407VET6mini.PcbDoc
Modules/STM32F407VET6-mini/src/STM32F407VET6mini.SCHLIB
