andreika-git/deucalion/Modules/STM32F407VET6-mini/CubeMX/CubeMX.ioc

Mcu.UserName=STM32F407VETx
PA10.Signal=USART1_RX
PA5.Signal=SPI1_SCK
PA6.Signal=SPI1_MISO
PA7.Signal=SPI1_MOSI
PA9.Signal=USART1_TX
PB10.Signal=SPI2_SCK
PB14.Signal=S_TIM12_CH1
PC14-OSC32_IN.Signal=RCC_OSC32_IN
PC15-OSC32_OUT.Signal=RCC_OSC32_OUT
PC2.Signal=SPI2_MISO
PC3.Signal=SPI2_MOSI
PH0-OSC_IN.Signal=RCC_OSC_IN
PH1-OSC_OUT.Signal=RCC_OSC_OUT
