andreika-git/deucalion/(commit log)

2019-01-03 update & add core407 board pics + dims estimate
2019-01-03 add more files, more 407 boards
2019-01-03 add Core407_pinout_compare and STM32 pdf
    [Core407_pinout_compare.xlsx]
2019-01-04 connectors, core407z & kinetis files
    [Core407_pinout_compare.xlsx, STM32F407VET6mini-PCB.PcbDoc, STM32F407VET6mini-PCB.PcbLib, STM32F407VET6mini.PcbDoc, STM32F407VET6mini.SCHLIB]
2019-01-07 We have the connector! +misc.updates
    [Bosch_M797_pinout.xlsx]
2019-01-07 Move obsolete brain-board folders away
    [STM32F407VET6mini-PCB.PcbDoc, STM32F407VET6mini-PCB.PcbLib, STM32F407VET6mini.PcbDoc, STM32F407VET6mini.SCHLIB]
2019-01-07 update + photos
    [Bosch_M797_pinout.xlsx]
2019-01-09 update & new files
    [Bosch_M797_pinout.xlsx]
2019-01-13 pin map initial commit & update
    [Bosch_M797_pinout.xlsx, pin_map.xlsx]
2019-01-15 small progress
    [pin_map.xlsx]
2019-01-15 update & fix Kinetis pinout
    [pin_map.xlsx]
2019-01-21 update & more DC-DC modules info
    [pin_map.xlsx]
2019-01-22 refactoring: pinout, TLE
    [pin_map.xlsx]
2019-01-28 pcb progress: 30% complete
    [pin_map.xlsx]
2019-01-29 add compatibility with Mikas 10.3
    [pin_map.xlsx]
2019-01-31 pcb progress: 60% complete
    [pin_map.xlsx]
2019-02-04 pcb progress: 91% complete ;)
2019-02-11 pcb progress: 99% complete
    [deucalion_bom.xlsx, pin_map.xlsx]
2019-02-13 pcb progress: 100%! Rev.0.1 is ready for production!
    [deucalion_bom.xlsx]
2019-12-02 update & new photos
    [pin_map.xlsx]
2020-01-02 schematics & more files
    [dc-dc-tests.xlsx]
